MBDurbin/VRB/PROJECT_CONTEXT.md

# Resistor Bank Master — Project Context

Self-contained summary of the system, its validated constants, and its open
questions. Written to be dropped into a Claude Project (or read cold by anyone
new to the repo).

Last updated: 2026-10-08. Reflects the move to Reliance RS50 cells and the
October 2026 safety-review fixes.

---

## What this system does

An FSAE electrical-load test rig. It discharges **one 12S4P module** through a
relay-switched resistor bank, following a recorded lap speed profile, so that
module can be characterized under realistic race loads without a car. The car
itself carries nine such modules in series; the rig reproduces what one of them
would experience. See Battery topology below — this distinction matters.

The lap profile drives a road-load physics model (drag, downforce, rolling
resistance, translational and rotational inertia, drivetrain loss) to compute
required power for each row. That power is converted to a target resistance,
quantized to the bank's 0.25 Ω steps, and sent to the resistor Arduino as an
8-bit binary word.

**Playback follows the profile's own `Time (s)` column**, via
`lap_row_interval()`. It used to advance one row per wall-clock second
regardless, which happens to match the shipped 1 Hz profile but would run a
10 Hz log ten times too slow *and* hold each power demand ten times too long,
over-draining the pack by the same factor. `compute_lap_physics()` already
derived acceleration from those timestamps, so fixed playback also made the two
disagree about how much time a row represents.

**Lap boundaries are continuations, not restarts.** `is_first_row` means the
standing start of the *run* (lap 1, row 0) — tying it to `row_idx == 0` alone
made every subsequent lap begin from rest, discarding the car's carried velocity
and dropping the acceleration term from that frame's power demand. And because
the profile's `Time (s)` restarts each lap, the raw difference at the boundary
is large and negative (`0.0 - 60.0`); the non-positive guard silently replaced
it with 1.0 s, dividing a real velocity change by a fabricated interval. That
frame now uses `lap_row_interval()` — the profile's own sampling rate, not a
literal, so it stays correct at any log rate.

Note the shipped profile begins and ends at 0 mph, so its own boundary is
benign. A multi-lap run on it is N repeats of a stop-to-stop lap rather than a
continuous stint. The fix matters for profiles that are loop-closed at speed.

`load_lap_profile()` drops rows with non-finite speed or time. Exported
telemetry commonly carries trailing blanks — the shipped profile has seven — and
NaN propagates to a NaN power demand, which loses every comparison in
`compute_target_resistance()` so `min(MAX_RESISTANCE, nan)` quietly returns
`MAX_RESISTANCE`. The bank sat at minimum load for the tail of every lap with
nothing reported.

## Architecture

Four processes communicating over bounded `multiprocessing.Queue`s. `main_v2.py`
orchestrates and picks the data source at startup.

```
                 daq_queue              telemetry_queue
hardware_manager ──────────> control_logic ──────────> gui_layout
  (or sil_simulator)              ^                        │
                                  └────────────────────────┘
                                       gui_cmd_queue
```

| Module | Role |
|---|---|
| `main_v2.py` | Entry point. Probes COM ports for a `SIL_KEY` dongle; if present runs SIL mode, otherwise starts the real DAQ process. |
| `rig_config.py` | Vehicle model, pack spec, DAQ mapping and safety limits, with JSON persistence. Everything a future team retargets lives here. |
| `theme.py` | Colour, type and spacing for the whole interface. One global stylesheet; widgets carry a `variant` property rather than inline CSS. |
| `hardware_manager.py` | Reads NI cDAQ (current + cumulative cell voltage taps, plus resistor-bank thermocouples on banks 1–4 in their own task and thread) and the temperature Arduino (OneWire buses of DS18B20s). Channel map and sensor layout come from config. Self-healing watchdog thread re-detects the temperature Arduino. Without the NI-DAQ it publishes zero current and voltage flagged `ni_daq` False, never simulated data. |
| `control_logic.py` | The safety-critical process. FSM, safety trips, lap physics, coulomb counting, resistor bank serial commands. |
| `gui_layout.py` | PyQt6 telemetry UI — live voltage/current plots, 12S cell voltages, 48-sensor thermal heatmap, resistor bank map laid out as built, threshold controls, CSV recording. |
| `sil_simulator.py` | Desk-test plant model. Replaces the DAQ entirely with operator-driven sliders (load, temperature, pack OCV) plus a hardware-fault toggle. |

These run the rig and stay at the top level. Lap profiles, bench tools, the
cooling analysis and the superseded prototypes each have their own folder; the
map is in [README.md](README.md).

### Finite state machine

```
DISCONNECTED ──> IDLE ──ARM──> ARMED ──RUN──> RUNNING
                  ^                              │
                  └──────────(laps complete)─────┘

any state ──STOP/trip──> FAULT ──RESET──> IDLE
```

Guards live in `is_valid_transition()`. `ARM` only from `IDLE`, `RUN` only from
`ARMED`, `RESET` only from `FAULT`, `STOP` always accepted. `ARM` is also refused,
staying in `IDLE`, while `arm_refusals()` is non-empty: the NI-DAQ is offline or
the configuration has ARM blockers (see Retargeting below).

`ARM`, `RUN` and `RESET` carry the time they were pressed
(`transition_command()`), and the loop ignores one pressed before the most
recent stop or fault (`stale_transition()`). Without that, a `RESET`, `ARM` and
`RUN` already waiting in the queue were processed straight after an E-STOP, in
the same pass, and the rig was `RUNNING` again with the next resistance command
reconnecting the load. A fault is cleared only by a `RESET` pressed after it.

## Hardware

- **Module under test**: 12S4P Reliance RS50 (21700, 5000 mAh, 70 A), 48 cells,
  ~50 V, 280 A. This is what the bench actually loads. It replaced the Molicel
  INR-21700-P45B the modules were first built with; see Cell constants below.
- **Car's battery** (reference only): 9 modules in series, 432 cells, ~450 V.
- **Resistor bank**: binary ladder of 8 relay-switched steps —
  0.25, 0.5, 1, 2, 4, 8, 16, 32 Ω. 0.25 Ω resolution, 63.75 Ω total, 255 steps
  in an 8-bit word. Wired across the module under test.
- **Resistor Arduino**: 9600 baud, answers `RESISTOR_CTRL` to `?WHOAMI`. Has an
  independent 2 s serial watchdog that opens the main contactor and sheds all
  load if the host goes quiet.
- **Temperature Arduino**: 115200 baud, answers `TEMP_SENSOR`. 6 buses × 8
  sensors, 9-bit resolution for speed, non-blocking state machine.
- **NI cDAQ**: modules 5–8, 10:1 dividers (`VOLTAGE_MULTIPLIER = 11.0`).

Both Arduinos and the SIL dongle are discovered by COM-port sweep using the
`?WHOAMI` handshake — no fixed port assignments.

**One process owns each device, and only that process sweeps for it.**
`control_logic` owns the resistor controller; `hardware_manager` owns the
temperature Arduino. Both used to hunt for `RESISTOR_CTRL`, which meant
`hardware_manager` could never claim the port `control_logic` was holding, so
its "still looking" flag never cleared and the sweep ran every 3 s forever —
blocking 2 s per baud per port, and DTR-resetting any Arduino it managed to
open. If a sweep landed inside `control_logic`'s reconnect cooldown it could
grab the resistor controller and reset it out from under the process driving the
bank. Keep discovery single-owner.

**[docs/hardware_topology.md](docs/hardware_topology.md) is the physical
reference**: what each ladder step is actually built from, how the bank is
arranged for cooling, the DS18B20 ROM address map, and the gaps between what the
hardware needs and what the software enforces. Two of those gaps matter before
any run — **there is no fan interlock**, and the bank has **no thermal
protection of its own**.

## Interface conventions

All styling lives in `theme.py` and is applied as one global stylesheet via
`apply_theme(app)`. Widgets declare intent with a `variant` property
(`primary`, `success`, `warning`, `danger`, `card`, `section`, `caption`,
`mono`) instead of carrying their own CSS, so the look stays coherent as the
interface grows. Three conventions are worth preserving:

- **Colour carries meaning.** Red is a fault or a hard limit, amber is a warning
  or an armed-but-not-running state, green is healthy or active. Nothing
  decorative uses those three, so an operator can trust what a colour means.
- **Live numbers are monospaced.** Proportional digits change width as values
  update, which makes readouts visibly twitch. Metric cards also hold a fixed
  width and static captions for the same reason — a caption that grows with its
  value makes the card reflow mid-run.
- **The E-STOP is deliberately the loudest control on screen** and sits apart
  from the routine controls, so it cannot be hit while reaching for Run or
  Reset. Do not tone it down for visual balance.

The thermal map ramp (`theme.HEAT_STOPS`) routes cool → teal → amber → red
rather than interpolating blue straight to red, which passes through a muddy
purple midpoint and makes mid-range cells impossible to rank.

## Retargeting the rig for a new car or new cells

**Start here if you have inherited this rig.** Click **⚙ CONFIGURE** in the GUI.
Nothing below requires editing Python.

The dialog has two tabs. **Vehicle** describes the car — mass, aero, tyres,
drivetrain. **Battery Pack** takes the numbers straight off your cell's
datasheet plus your series/parallel counts. Pack limits are *derived* from those
values, so entering `70 A` continuous and `4P` produces a 280 A pack rating
automatically; you should never be hand-computing a pack limit.

A live panel shows the derived pack figures and the resulting trip points as you
type, and warns in red if a limit would exceed what the cells are rated for.
Settings persist to `rig_config.json` beside the source, so they survive
restarts and travel with the repo.

One safety rule is enforced in the derivation: **the E-STOP fires at
`max_amps + amp_buffer`, so the buffer is taken out of the cell rating, not
added on top of it.** With the RS50's 280 A pack and a 5 A buffer the operating
limit derives to 275 A and the trip lands exactly on 280 A. Deriving the limit
as the raw rating would put the real trip at 285 A — above the cells — which is
exactly the bug that shipped originally, on the P45B's 180 A pack, as
182 A / 187 A.

Hand-editing a threshold in the sidebar that derivation computes (V crit, cell
min, max current, max temp, derate start) sets `derive_from_pack = False`, so
your override is not reverted the next time the config loads. Re-enable
derivation by editing that flag in `rig_config.json`. The other sidebar controls
are not overrides and leave derivation on: **V warn** only moves a dashed line on
the plot and never reaches the controller (it used to switch derivation off for
every limit), and changing the **E-stop buffer** or the **thermal derate**
switch re-derives, so max current follows a new buffer and the trip stays on the
cells' rating.

**What the window shows is checked against what the controller is using.** The
logic process reports its limits in force and a fingerprint of its vehicle, pack
and wiring (`settings_fingerprint()`) in every telemetry packet. If they differ
from the window's for more than a second, a red `NOT IN FORCE ON THE
CONTROLLER` line appears beside the car and pack label, naming the setting. That
catches a config the controller rejected and a `SET_LIMITS` or `SET_CONFIG` the
bounded command queue dropped. Configure is refused outright while RUNNING,
because the controller ignores a new config mid-run; it used to apply and save
it in the window anyway, so a lowered max temp could look active when it was
not. The Configure preview also works on a copy of the limits now: it used to
re-derive into the live limits on every keystroke, so Cancel undid nothing.

**Editing `rig_config.json` by hand is different.** If you change a limit there
and leave `derive_from_pack: true`, derivation still wins — that is deliberate,
because a pack change must move the limits with it, or new cells inherit the old
pack's ceiling. What is *not* acceptable is doing it quietly: the reversion can
run in the unsafe direction, turning a deliberate derate from 120 A back into
175 A. So every discarded value is now reported on the console at startup and in
a dialog when the GUI opens. If you meant the edit, set `derive_from_pack` to
`false`.

The **DAQ / Sensors** tab holds the channel mapping and sensor layout: which
cDAQ channel reads current, the ordered list of cumulative voltage taps, divider
and transducer scaling, analog input range, OneWire bus/sensor counts, and the
loop period. These describe physical wiring, so they cannot be *derived* from
S/P counts — but they must agree with them, and the dialog says so in red when
they do not (e.g. "12 voltage channels configured but the pack is 14S").

**Configuration problems come in two classes, and one of them blocks ARM.**
`RigConfig.arm_blockers()` lists the ones that leave part of the module or bank
unwatched: a voltage-tap count that does not match the series count, the
current channel or a thermocouple on a voltage input, duplicate channels, an
invalid thermocouple type or cold-junction source, a non-positive divider or
transducer scale (zero reads no current; negative reads discharge as negative,
which never reaches the over-current trip), a staleness timeout at zero (which
switches that monitor off), any limit that is not a finite number (a trip set to
NaN never fires), and any trip set past a rating, so that it fires only after the
damage: over-current above the pack rating, max temp above the cell's ceiling,
undervoltage below the cutoff, or a resistor trip above its element's rating.
These used to be printed as warnings and the rig armed anyway. They are judged
on the limits the logic process actually holds, so a **sidebar edit** counts the
same as the config file. The logic refuses `ARM` while any stand, the main
window says why in red beside the hardware pills, and a config or sidebar change
that introduces one while armed faults as `CONFIG FAULT` and kills the load.
Everything else is an advisory (`RigConfig.advisories()`), shown and left to the
operator: a derate that cannot ramp (it fails safe to no load), a thermistor
count that does not match the cell count, no resistor thermocouples or a bank
with a trip and no thermocouple, and a bad sample period. Fewer thermistors than cells and missing
thermocouples are advisories by choice, so a rig still being instrumented can
arm; an armed rig whose thermocouples deliver nothing still faults as
`NO RESISTOR TEMP DATA`. A config with blockers can still be saved, so a team
mid-rewire can save and restart.

**The resistor bank is held to its power ratings per bank**, not just to its
8 kW total, and a sidebar switch chooses between 100% and 140% of them. See
"The bank's power ratings" in [docs/hardware_topology.md](docs/hardware_topology.md).

DAQ changes only take effect on restart, because the NI task and sensor buffers
are built once at process start. The GUI tells you this after saving rather than
letting you believe a rewiring change is already live. ARM is judged against the
wiring the DAQ is actually running, so correcting a channel list in the dialog
does not unblock it until after the restart.

### What retargeting does NOT cover

- **Arduino firmware.** The temperature sketch hardcodes 48 DS18B20 ROM
  addresses across 6 buses. A different sensor count means editing and
  re-flashing the sketch — the Python side will read whatever layout you
  configure, but the addresses themselves live in firmware.
- **Resistor bank hardware.** 8 relays, 0.25 Ω resolution, 63.75 Ω max are
  physical properties of the bank.
- **Physically rewiring the DAQ.** Configuring 14 channels does not create them;
  you need the modules and the taps.

Everything on the Python side now follows the config: the DAQ derives cell
voltages by differencing however many taps are configured, sizes its temperature
grid from the bus/sensor counts, and the GUI adapts its cell list, thermal map
and CSV columns to match.

## Vehicle model

All road-load parameters live in the `VehicleParams` dataclass in
`rig_config.py` (re-exported from `control_logic` for convenience) — nothing
physics-related is hardcoded in the maths any more. Edit these from the GUI's
Configure dialog, or pass a variant per call:

```python
fast = VehicleParams(drag_coefficient=0.55, rotational_mass_factor=1.08)
compute_required_power(velocity_ms, acceleration, params=fast)
```

| Field | Default | Notes |
|---|---|---|
| `mass_car_kg` / `mass_driver_kg` | 260 / 70 | 330 kg total |
| `rotational_mass_factor` | 1.05 | Wheels, rotors, axles, drivetrain as virtual mass |
| `air_density_kgm3` | 1.2255 | ISA sea level, 15 °C |
| `gravity_ms2` | 9.81 | |
| `drag_coefficient` / `drag_area_m2` | 0.6 / 2.224 | |
| `lift_coefficient` / `downforce_area_m2` | −1.0 / 2.224 | Negative Cl = downforce |
| `rolling_resistance_coeff` | 0.015 | Applied to the *dynamic* normal force |
| `drivetrain_efficiency` | 0.95 | Chain/gears/bearings |

Two modelling subtleties that are easy to get wrong and are locked by tests:

- **`rotational_mass_factor` applies to acceleration only.** Spinning components
  resist changes in speed but do not press the tyres into the track, so the
  factor must not reach the normal force behind rolling resistance. It has zero
  effect at steady speed.
- **Drivetrain efficiency is asymmetric.** Driving divides by η (the powertrain
  must produce more than reaches the road); braking multiplies by η (friction
  eats part of what would return). η is clamped to [0.01, 1.0] at the use site
  so a mistyped value cannot divide by zero inside the safety-critical process.

`compute_road_load_forces()` returns the individual force terms (drag,
downforce, rolling, accel, total) so the breakdown can be inspected and tested;
`compute_required_power()` builds on it and applies the efficiency correction.

Effect of the rotational-mass and efficiency terms versus the earlier model:
**+5.26 %** at steady speed (efficiency alone), rising to **+10.3 %** under hard
acceleration. At 10 m/s and a = +8 m/s² that moves the bank from 6.73 Ω to
6.10 Ω — roughly two 0.25 Ω steps, so it is resolvable by the hardware rather
than lost in quantisation.

## Cell constants — Reliance RS50

The module has been **Reliance RS50** since it replaced the Molicel
INR-21700-P45B. The figures come from the supplier's listing (liionwholesale.com,
"Reliance RS50 70A 5000mAh Flat Top 21700"); there is no RS50 datasheet in the
repo yet. Two figures the rig needs are **not on that listing** and are flagged
below. The P45B's datasheet stays in `datasheets/` for reference: some tests pin
the derivation math to its published figures.

| Quantity | Cell | 12S4P module | Source |
|---|---|---|---|
| Capacity | 5000 mAh typical, 4950 mAh min (0.2 C) | 20.0 Ah (19.8 Ah min) | listing |
| Full charge | 4.2 V | 50.4 V | listing ("peak voltage") |
| Nominal | 3.6 V | 43.2 V | listing |
| Max continuous discharge | 70 A "with 80 °C temperature cut-off" | **280 A** | listing |
| Discharge temperature limit | 80 °C | 80 °C over-temp trip | listing (its only temperature figure) |
| Discharge cutoff | 2.5 V | 30.0 V absolute floor | **not on the listing** — usual for the class; confirm |
| DC internal resistance | 4 mΩ | 12 mΩ | **not on the listing** — an estimate; confirm or measure |
| Energy | 18 Wh | 864 Wh | 5.0 Ah × 3.6 V |
| Charge current | 15 A max, 8 A standard | — | listing; the rig never charges |

Pack derivation (`derive_from_pack: true`) turns these into the trips: 275 A
operating current and a 280 A over-current trip, 80 °C max temp, 36.0 V module
undervoltage (3.0 V/cell), 2.70 V per cell, and a 38.0 V warning line.

**80 °C is the right trip for this cell.** The P45B needed care here: its 45 A
rating carried an 80 °C *test* cut-off while its discharge operating range
stopped at 60 °C, so the rig used 60. The RS50 listing gives only the 80 °C
cut-off with its 70 A rating and no separate operating range, so the rig trips at
80. Lower `cell_max_temp_c` if an RS50 datasheet gives a narrower discharge range.

**Why the undervoltage trip sits at 36.0 V and not 30.0 V:** headroom for sag.
The RS50 module's 12 mΩ sags 3.4 V at its 280 A rating, about 2.4 V at the
~200 A the ladder can actually draw. The 3.0 V/cell figure came from the P45B,
whose 45 mΩ sagged 8.1 V at 180 A; it still leaves the RS50 well clear of its
cutoff.

`rig_config.json` used to say `max_amps: 180`, the P45B's figure. With
`derive_from_pack: true` it was replaced by the RS50's 275 A on every load, behind
a "hand-edited limits were replaced" dialog, so 275 A was already in force. The
file now says 275.

### What bounds the load: battery current and bank power

Two independent limits, each enforced on what is commanded and again as a trip:

| Limit | On the command | As a trip | Can configuration raise it? |
|---|---|---|---|
| **Battery current** — 280 A for the RS50 module (70 A × 4P) | Resistance never below V ÷ 275 A, rounded up a step | Over-current at 275 + 5 = 280 A, in any state | No: a trip above the pack rating blocks ARM |
| **Bank power** — 8 kW ladder total and each bank's own rating (`BANK_RATED_POWER_W`) | Every setting checked against both at worst-case tolerance; one that fails moves to the nearest that passes | Ladder V × I in any state; each bank's share once a setting has settled | Only between 100% and 140% (the sidebar switch) |

**With the RS50 the bank binds first.** The 0.25 Ω bottom step limits a full
50.4 V module to about 202 A, under the cells' 280 A, so the over-current trip is
a backstop for a fault such as a shorted ladder rather than a limit the rig
reaches in use. At full charge the heaviest load is 0.25 Ω and ~10.2 kW with the
default 140% bank setting; held to rated power, it is 0.75 Ω and ~3.4 kW above
43.6 V. `tests/test_shipped_limits.py` runs every setting the shipped config can
command, across the charge range and at both bank settings, against both limits.

## Battery topology — read this before touching the physics

**The bench loads ONE module. The car has nine of them in series.** Almost every
mistake in this codebase has come from conflating the two.

- A module is `series_count` × `parallel_count` cells (default 12S4P, ~50 V).
- The car's battery is `modules_in_series` (default 9) of those in series, ~450 V.
- The DAQ reads taps on **one** module, and the resistor bank is wired across
  **that one module only**. So `voltage` in the telemetry packet is ~50 V, and
  the bank never sees 450 V.
- Series modules all carry the same current, so **the RS50 module's 280 A is
  simultaneously the per-module limit and the whole-battery limit**. Current limits do not scale
  with module count.

The lap physics computes power for the **whole car**, drawn from the 450 V
battery. Reproducing that on one module means reproducing its **current**:

```
I_car = P_car / V_battery = P_car / (N · V_module)
R     = V_module / I_car  = N · V_module² / P_car
```

So the module count enters the power term **linearly**, and both current clamps
divide the **module** voltage, because that is what is actually across the bank.

This was the source of a real bug. The term read `(voltage * 9) ** 2` — N²
rather than N, which is the resistance for a bank spanning the entire battery.
On a single-module bench that **under-loaded by a factor of 9** across the whole
lap: an 81 kW demand drew 20 A instead of 180 A, and no plausible car power could
reach the ladder's 0.25 Ω step (it would have needed 810 kW). With the fix, 81 kW
lands at 180 A and 0.278 Ω — just above the smallest step, which is what the
hardware was sized for.

Sanity check any change here against the ladder: 0.25 Ω ↔ 200 A ↔ ~90 kW.

## Safety layers

Three independent layers. They must all be verified separately.

1. **Software trips** (`evaluate_safety` in `control_logic.py`) — over-temp,
   over-current, module undervoltage, **per-cell undervoltage**, cell sense
   fault, and **temperature data staleness**. Measured dangers are reported
   ahead of data-integrity faults, so an over-current with a dead thermal link
   reports the current. Sends `KILL` to the resistor Arduino and latches
   `FAULT`, which only a manual `RESET` clears.

   Two of these exist because pack-level checks alone were not enough:

   - **Per-cell undervoltage.** Eleven cells at 3.40 V plus one at 1.00 V totals
     38.4 V — above a 36.0 V module trip — while that one cell is destroyed. A
     module-total trip cannot see it. Readings below `cell_sense_floor` report
     as a sense fault rather than undervoltage, because a flat cell and an
     unplugged sense lead are indistinguishable and both must stop the run.
   - **Temperature staleness.** The DAQ republishes its last temperature array
     when the sensor link drops, so a dead sensor looks like a steady pack. A
     link lost at 52 °C froze the reading at 52 °C and the overtemp trip could
     never fire while the cells kept heating. Readings now carry an age and are
     refused past `temp_stale_timeout_s`.

   **Over-temperature and over-current are checked in every state.** Everything
   else — undervoltage, per-cell, and all data-integrity checks — applies only in
   `ARMED`/`RUNNING`, because before arming those readings describe a bench that
   is not loaded yet. A rig powered up before the battery is plugged in reads
   0.0 V; tripping on that in `IDLE` latched a fault `RESET` could not clear
   (back to `IDLE`, instantly re-trips) and locked the operator out of software
   bring-up entirely.

   Once armed, missing data is a **fault**, not a reason to skip a check.
   `check_cell_safety` reports `NO CELL DATA` on an empty array rather than
   returning safe — a broken harness or empty channel list would otherwise run a
   high-power profile blind to exactly what that check exists for.

   **Readings are checked before any trip trusts them** (`measurement_problems()`,
   once armed). NaN loses every comparison, so a packet of NaN current, voltage
   and cells used to pass every trip; and a packet with one cell, one sensor and
   one thermocouple passed too, because nothing counted them. Now:
   `INVALID READING` for anything not a finite number, a current below −20 A
   (a reversed or saturated transducer hides over-current), a module above 110%
   of full or a cell more than 0.8 V above full (either can never trip
   undervoltage), or a cell temperature below the DS18B20's −55 °C; and
   `INCOMPLETE DATA` when the counts of cells, temperature sensors or
   thermocouples differ from the wiring. Empty arrays keep their own names
   (`NO CELL DATA` and its siblings). The temperature parser also drops any
   value outside −55…125 °C, so the library's −127 "disconnected" value can
   never count as a fresh reading (the sketch already sends `ERR` for it). A
   NaN current sample is skipped by the coulomb count rather than freezing the
   SOC at 100%.

   **No simulated pack without the NI-DAQ.** `hardware_manager` used to
   substitute a healthy pack at rest (15 A, every cell at nominal + 0.5 V) when
   the DAQ failed to start, so a rig started without its DAQ drove the real bank
   while the overcurrent, undervoltage and cell trips watched made-up numbers.
   It now publishes zero readings with `hardware_status['ni_daq']` False. `ARM`
   is refused on them (the state stays `IDLE`, nothing to reset), and a DAQ lost
   after arming faults as `NI-DAQ OFFLINE` on the next packet and kills the load
   rather than waiting out `DAQ DATA STALE`. A failed read no longer ends the DAQ
   process, so temperatures keep reaching the GUI; it does not retry, so restart
   once the DAQ is back. Desk testing on simulated data is what the SIL dongle
   is for.

   **The logic loop never skips its body.** It previously did `continue` when the
   DAQ queue was empty, which jumped past GUI commands, every safety check, the
   resistor heartbeat and telemetry forwarding. A hung DAQ therefore paralysed
   the logic process: the operator's E-STOP sat unread in the queue and the GUI
   kept displaying `RUNNING`. The Arduino's own 2 s watchdog still shed the load,
   but nothing in software noticed or reported it. The loop now carries the last
   packet forward tagged with its age, and `DAQ DATA STALE` faults on it.

   **A failed write to the resistor controller is a lost link.** Every write
   goes through `write_resistor()`, which returns False rather than raising. A
   failed heartbeat, command or KILL, or a port that closes under the loop,
   closes the handle, re-arms discovery and, if ARMED or RUNNING, latches FAULT
   (`RESISTOR LINK LOST`). Heartbeat and command failures used to be swallowed,
   leaving the GUI showing a connected controller and RUNNING; the KILL writes
   were unguarded and could crash the process. Writes time out after 0.25 s
   rather than blocking. The loop sits in `try/finally`, so however it ends the
   load is killed and the port closed, and an unexpected error sends the GUI a
   final FAULT packet. **Limit:** the firmware does not answer `alive`, so a
   controller that hangs while still enumerated is not detected by the host;
   its own 2 s watchdog is what sheds the load then.
2. **Operator E-STOP** — GUI button, raises its own latched `estop_event`
   (`request_estop()`) rather than queueing a `STOP`, and the logic loop takes it
   ahead of every queued command. It used to go through
   `send_command_nonblocking()`, which makes room in a full queue by taking an
   old command out; a `multiprocessing.Queue` can refuse that for a moment after
   its own puts, so a STOP pressed into a full queue could be dropped while
   heartbeats carried on and the Arduino watchdog never fired. An Event has no
   capacity to run out of. Any `ARM`, `RUN` or `RESET` pressed before the stop
   is void (see the state machine above).
3. **Arduino serial watchdog** — 2 s of host silence opens the main contactor
   and sheds all load, independent of the host entirely.

Layer 3 is the backstop when layer 1 is stalled (see Open Questions).

## Testing

```bash
python -m pytest
```

194 unit tests, no hardware required. They cover the pure decision logic extracted
from the control loop: trip thresholds at/around boundaries, FSM transition
guards, coulomb counting and SOC clamping, the thermal derate curve, road-load
power, and the E-STOP command dispatch path.

`tests/SIL_CHECKLIST.md` is the manual desk-test procedure for what unit tests
structurally cannot reach — process/queue plumbing, GUI responsiveness, timing,
and shutdown hygiene. Requires the SIL dongle; no battery or DAQ needed.

## Bugs found and fixed (2026-07-23 → 25)

| Bug | Consequence |
|---|---|
| DAQ process never started in physical mode | `daq_queue` stayed empty, control loop never ran without the SIL dongle — bank and safety monitors effectively dead |
| Arduino watchdog never reset `MainRelay` after the first timeout | One serial hiccup stranded the main contactor open until power cycle |
| `auto_detect_resistor()` probed at 115200 vs the Arduino's 9600 | `?WHOAMI` handshake could never succeed |
| Reconnect scans ran every DAQ tick, no cooldown | Telemetry loop stalled seconds at a time (~2–4 s per COM port) |
| Spinboxes used Qt default `keyboardTracking` | Typing `100` into Max Temp emitted 1 → 10 → 100; the intermediate `1.0` applied as a live limit and tripped a spurious OVERTEMP kill mid-run |
| GUI buttons used blocking `.put()` on a bounded queue | A full queue froze the UI including E-STOP |
| Derate divided by `(max_safe_temp - derate_start_temp)` unguarded | `ZeroDivisionError` crashed the safety-critical process on misconfigured thresholds |
| **No undervoltage protection existed** | `V Warn`/`V Crit` only moved dashed lines on the plot; they were never sent to the logic process. Nothing prevented discharge past the 2.5 V/cell cutoff |
| Current limit 182 A, temp limit 65 °C (P45B pack) | Both exceeded datasheet ratings (180 A / 60 °C). E-STOP only fired at 187 A = 46.75 A/cell, 3.89 % over rated |

## Open questions and known gaps

**0. Coulomb count carries across runs, and only rebaselines on restart.**
`RUN` used to reset `remaining_ah` to full, so two manually-triggered
back-to-back laps both started at 100% and the counter forgot what the first
drew — overstating remaining charge, the dangerous direction. It now carries
over, and the starting SOC is printed when a run begins. It rebaselines on a
pack/config change or a process restart. If you want an explicit "fresh battery"
reset in the GUI, that is a deliberate affordance someone should add; silently
doing it on every `RUN` was not.

**1. SOC reads optimistically high.** `coulomb_step` integrates against a fixed
20.0 Ah nameplate figure. Two problems: it uses *typical* capacity (5000 mAh)
rather than *minimum* (4950 mAh, → 19.8 Ah), overstating by up to 1 %; and it
ignores rate dependence, though the ~200 A the ladder can draw is a 10 C
discharge where real deliverable capacity is meaningfully lower. Quantifying the
second needs a discharge-rate curve, and the RS50 listing has none.

**2. The regen branch of the power model is currently inert.**
`compute_target_resistance()` maps any `req_power <= 0` to `MAX_RESISTANCE`, so
braking power of −51.7 kW and −52.2 kW command the same 63.75 Ω — the bank is
purely dissipative and cannot recover energy. The braking efficiency correction
is still physically correct and matters if computed power is ever used for
energy prediction, but it does not change bank behaviour today. Coulomb counting
uses measured current, not this figure, so it does not propagate there either.

**3. E-STOP latency during port scanning.** The queue fix guarantees the GUI
never freezes, but the logic process still cannot *act* on a STOP while blocked
inside `auto_detect_resistor()`. This is tolerable only because `res_ser` is
`None` during a scan — the resistor Arduino is disconnected, so its own 2 s
watchdog has already shed load in hardware. **This means load-shedding in that
window rests entirely on the Arduino watchdog, not on software.** Verify on the
bench.

**4. The `SIL_KEY` dongle firmware is not in this repo.** `main_v2.py` probes for
a device replying `SIL_KEY` to unlock software-in-the-loop mode, and no such
sketch exists on the development machine. The other three sketches now live in
`arduino/` — see that folder's README. If the dongle exists, its firmware is
elsewhere and should join them.

**5. No cross-validation between threshold spinboxes.** Nothing prevents setting
`V Warn` below `V Crit`, or `Derate Start` above `Max Temp`. The derate case now
fails safe rather than crashing, but the UI still accepts nonsense combinations.

**6. Everything so far is desk-tested only.** No validation against real
hardware, real cells, or real current has been performed.
