MBDurbin/VRB/analysis/plots/CFM_vs_Resistor_Count.png

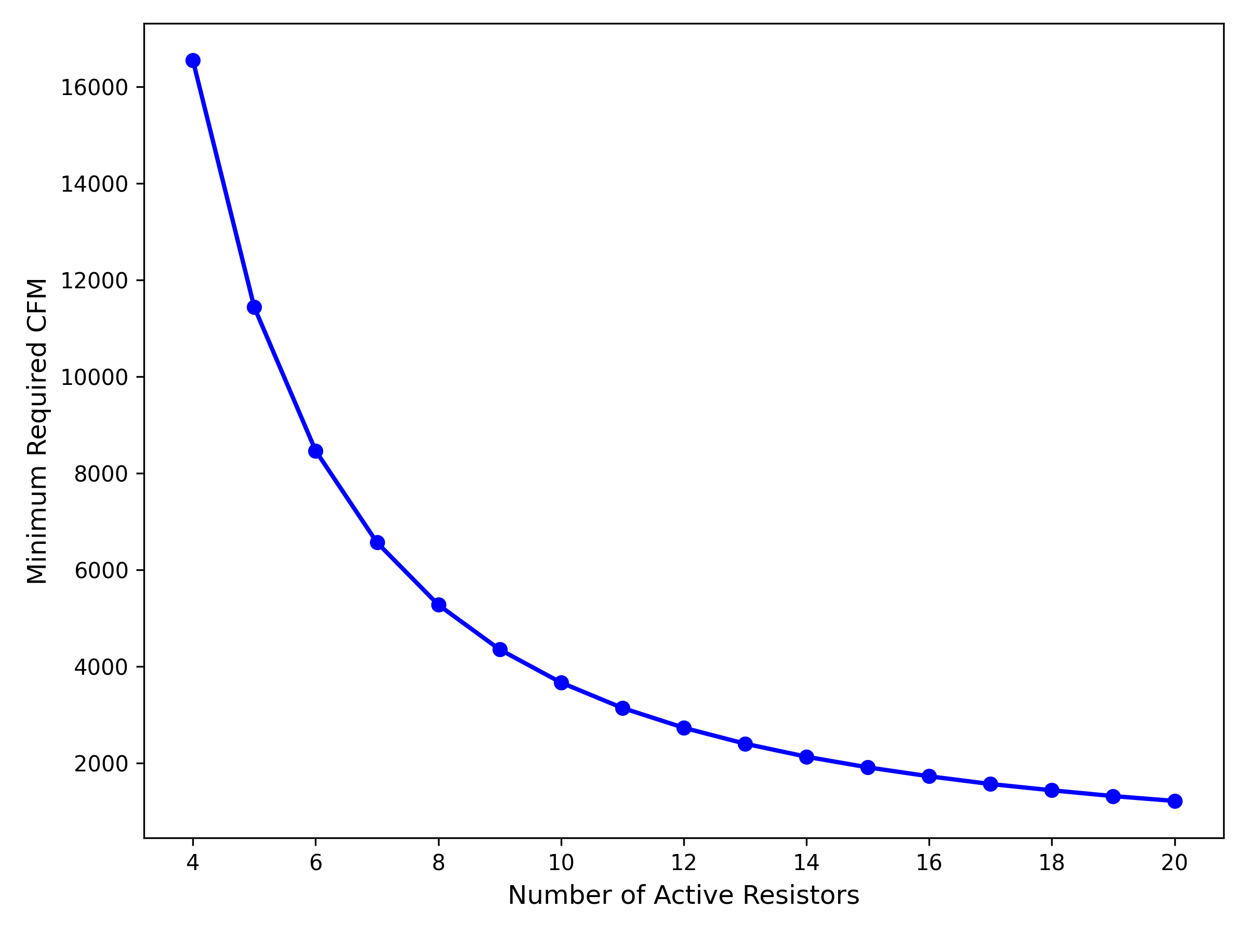
analysis/plots/CFM_vs_Resistor_Count.png
