MBDurbin/VRB/analysis/plots/CFM_vs_Surface_Temp.png

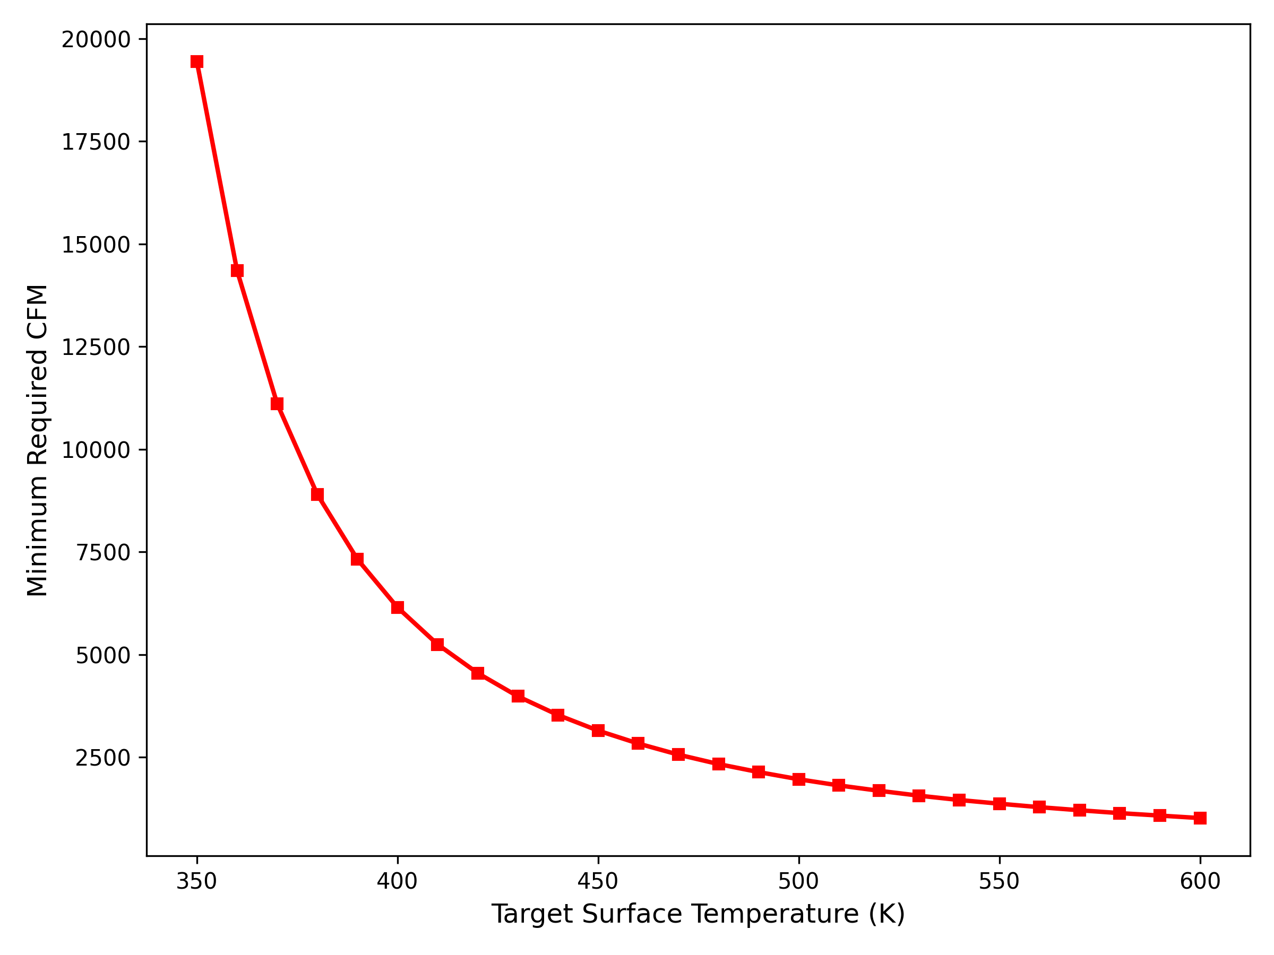
analysis/plots/CFM_vs_Surface_Temp.png
