MBDurbin/VRB/analysis/plots/Sensitivity_1_Clean_LogScale.png

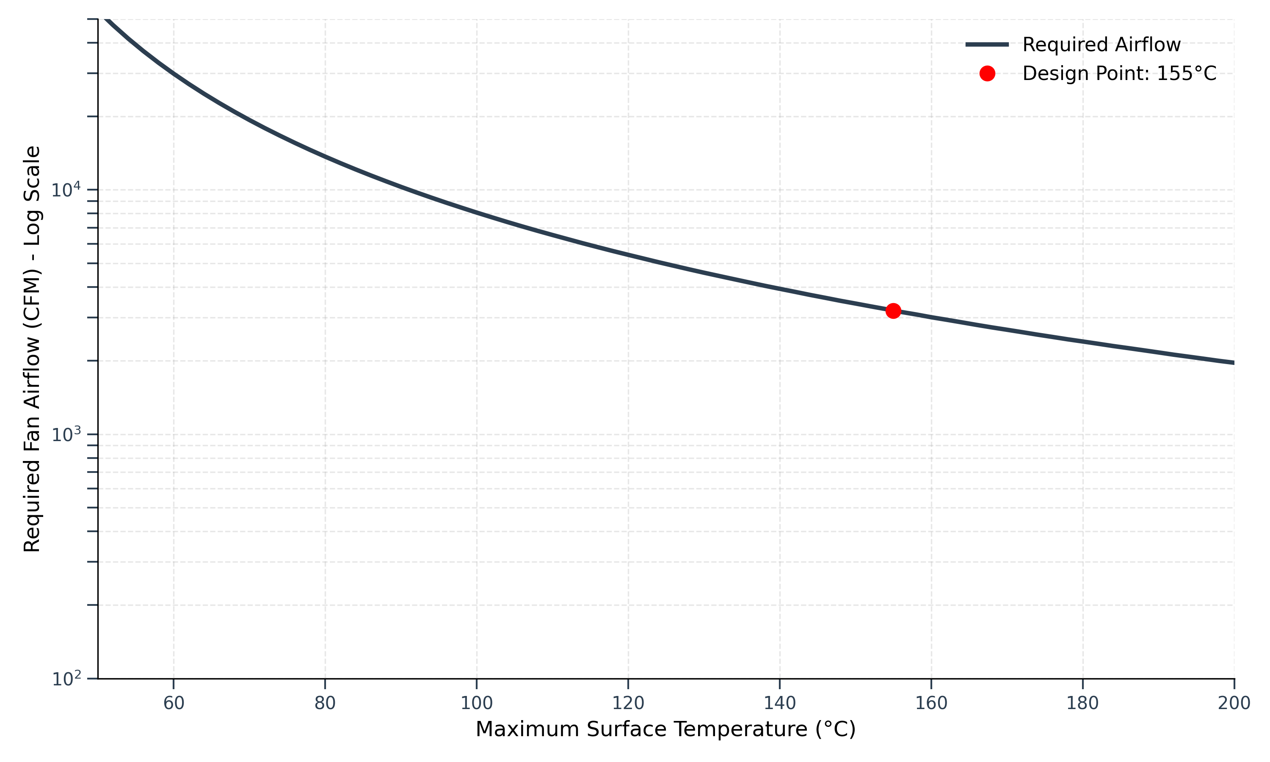
analysis/plots/Sensitivity_1_Clean_LogScale.png
