MBDurbin/VRB/analysis/plots/Sensitivity_1_Surface_Temp.png

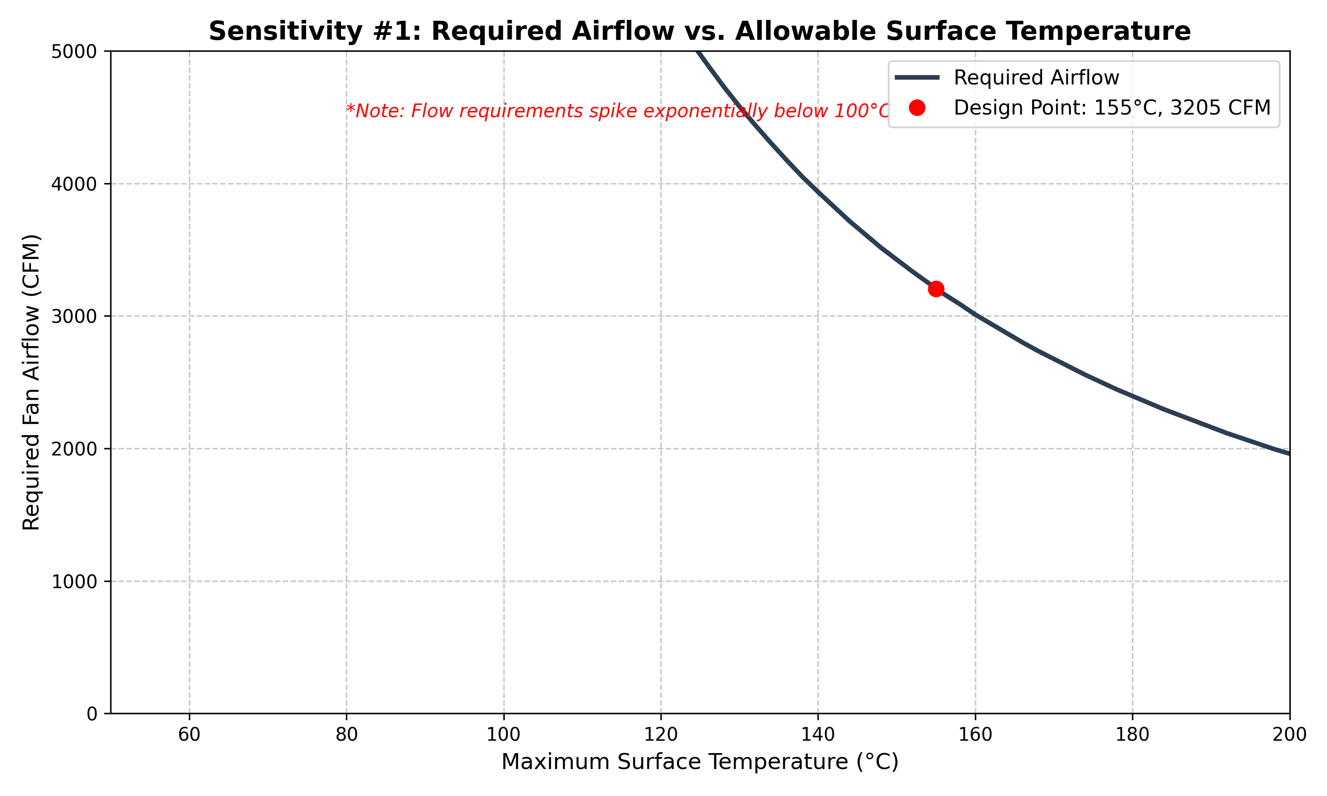
analysis/plots/Sensitivity_1_Surface_Temp.png
