MBDurbin/VRB/analysis/plots/Sensitivity_1_Surface_Temp_LogScale.png

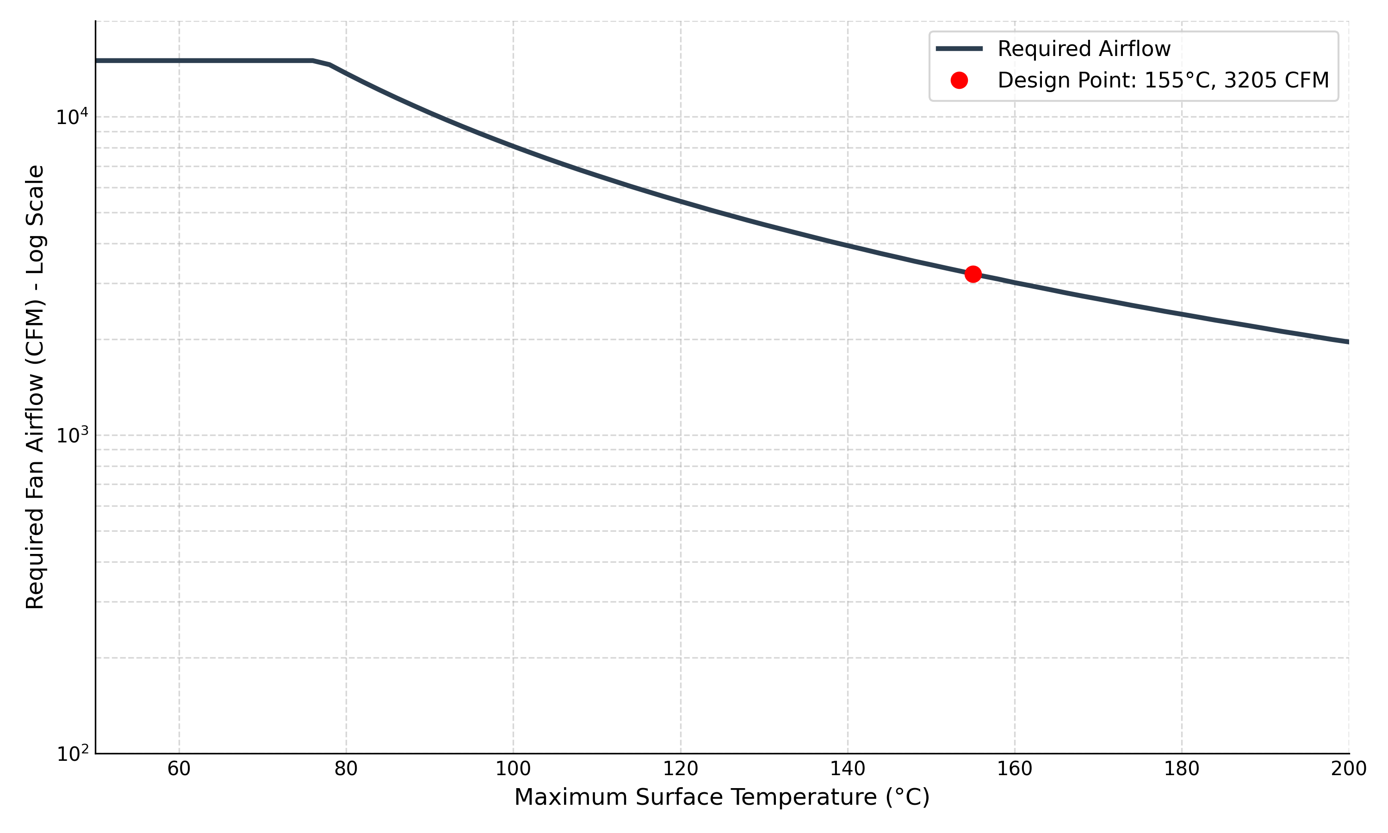
analysis/plots/Sensitivity_1_Surface_Temp_LogScale.png
