MBDurbin/VRB/analysis/plots/Sensitivity_2_Resistor_Count.png

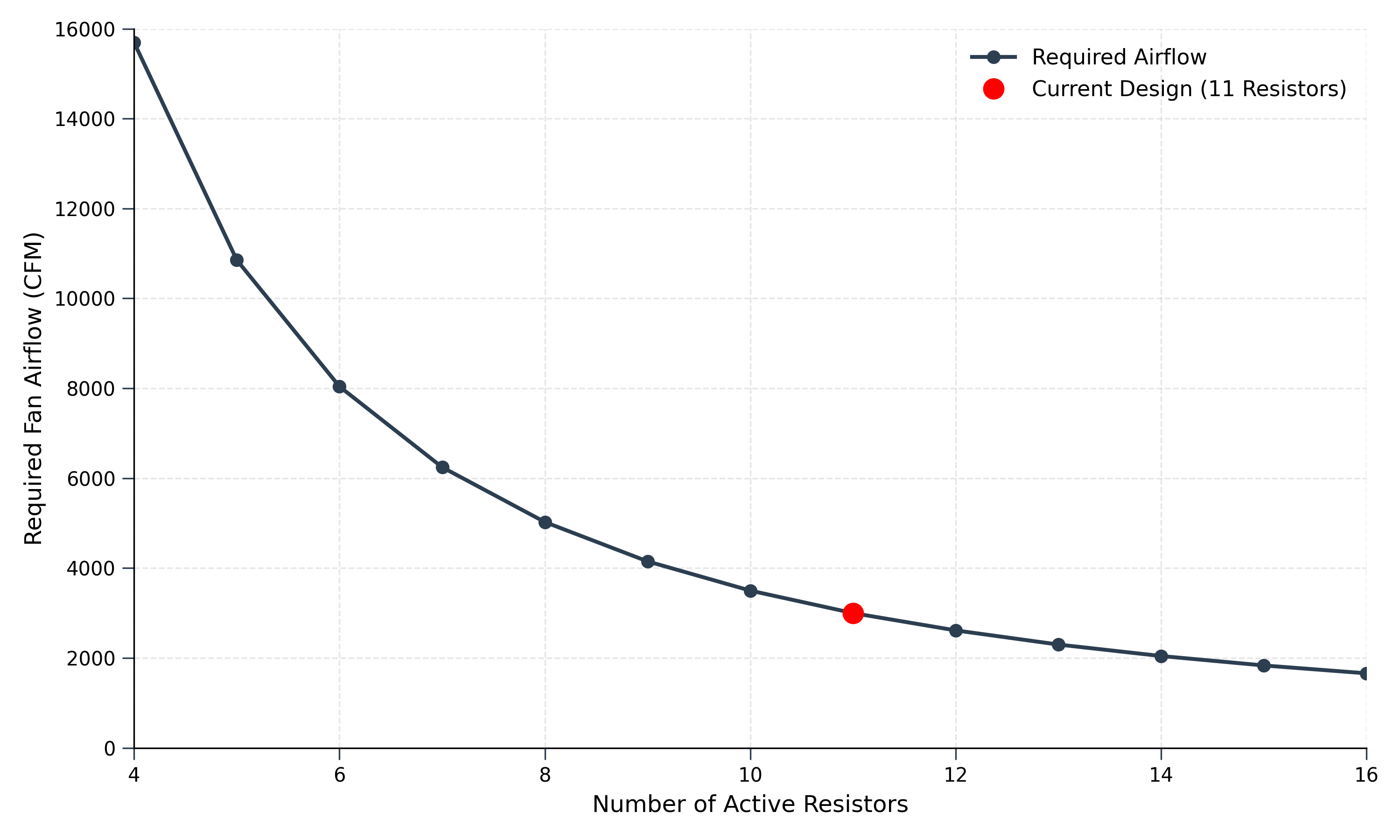
analysis/plots/Sensitivity_2_Resistor_Count.png
