MBDurbin/VRB/analysis/plots/Thermal_Peak_vs_Airflow.png

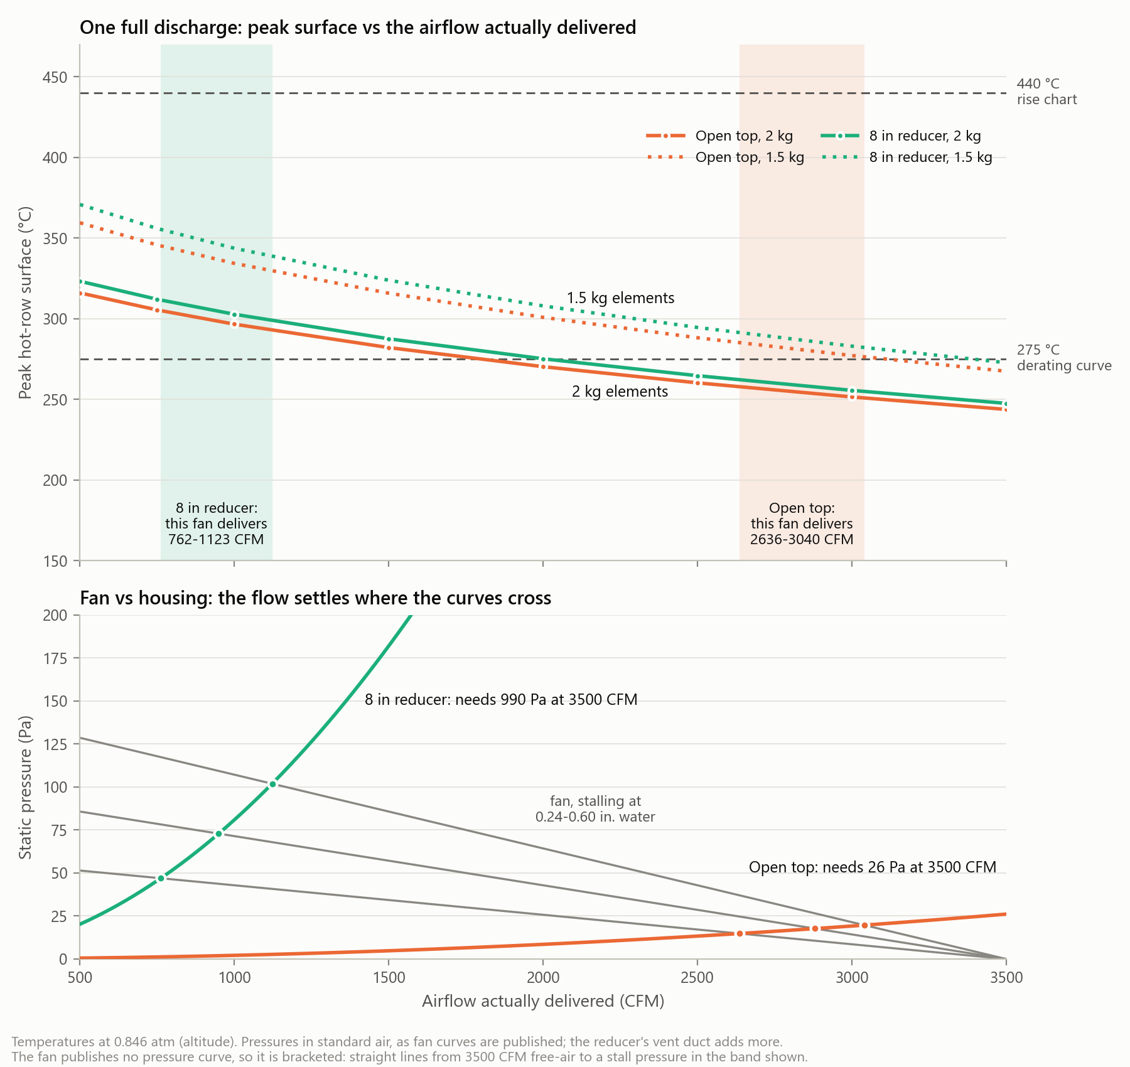
analysis/plots/Thermal_Peak_vs_Airflow.png
