MBDurbin/VRB/analysis/plots/Thermal_Steady_State.png

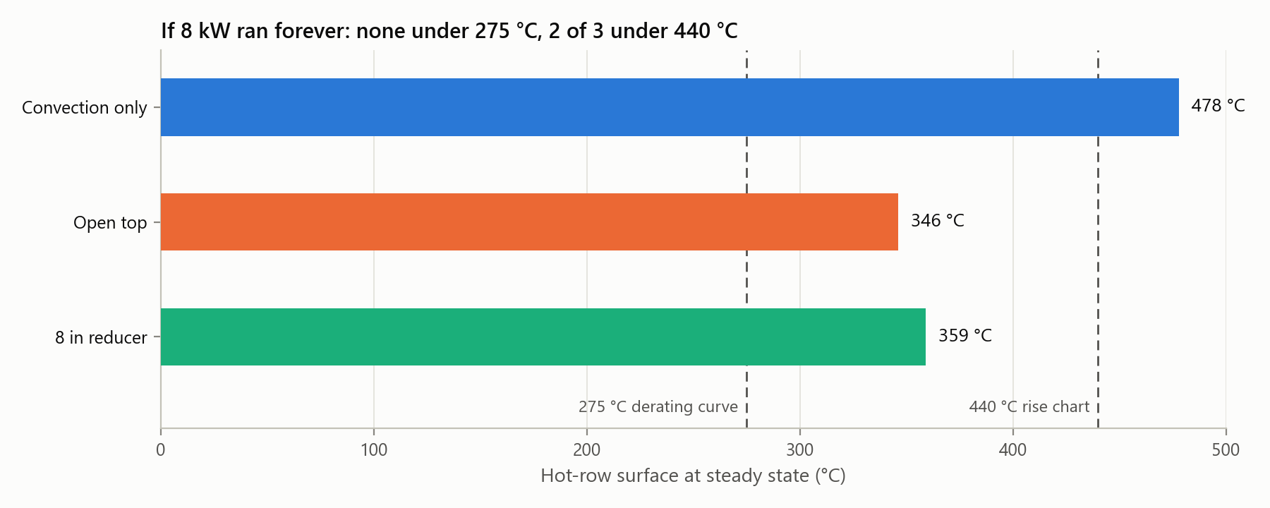
analysis/plots/Thermal_Steady_State.png
