MBDurbin/VRB/analysis/plots/Thermal_Transient_Surface_Temp.png

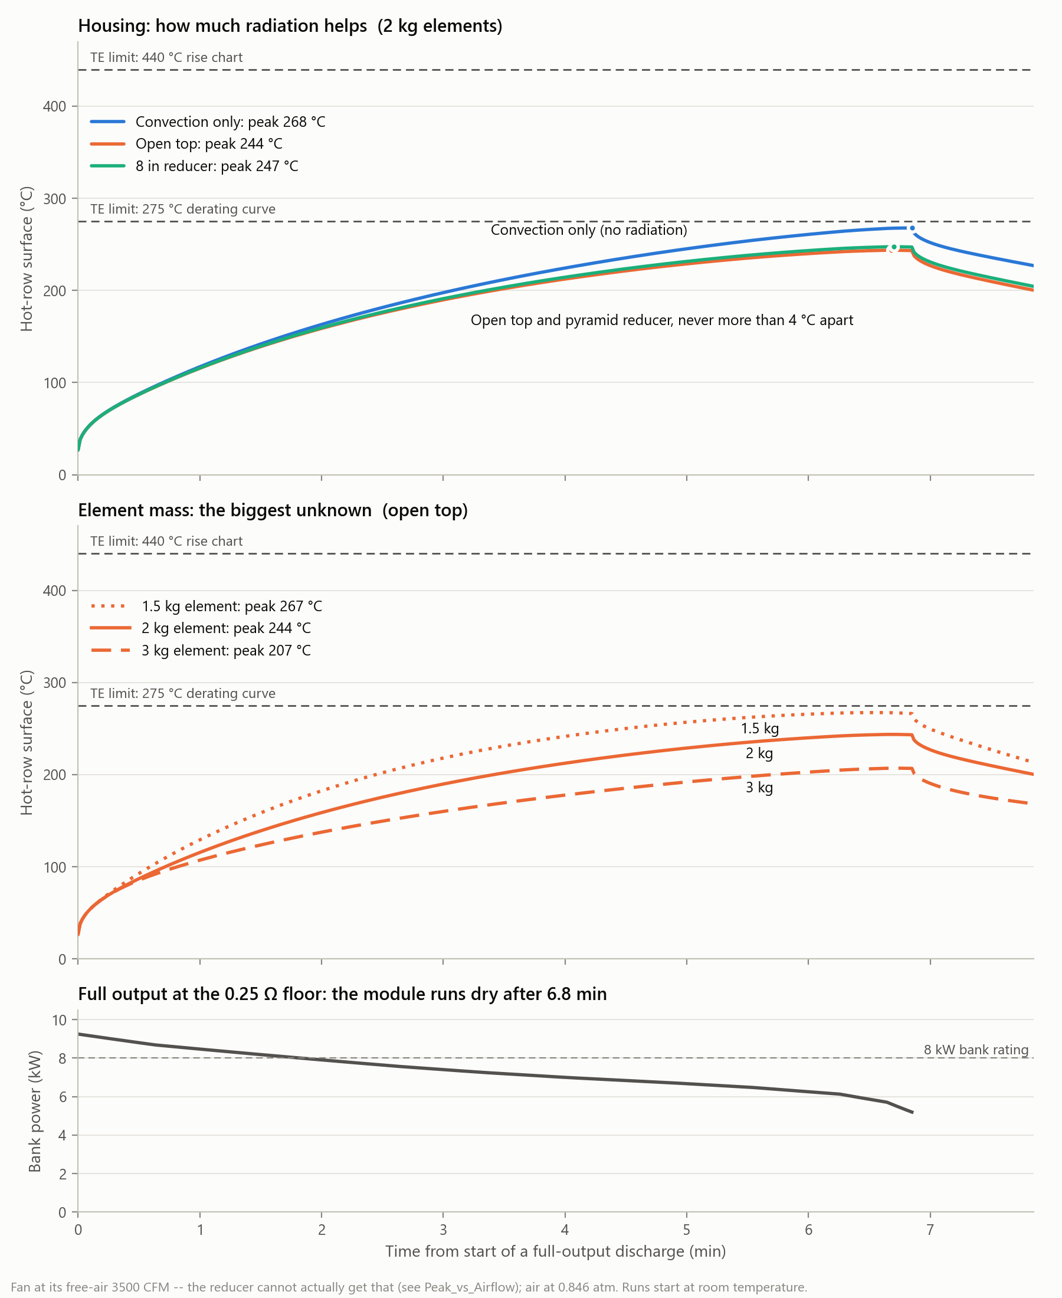
analysis/plots/Thermal_Transient_Surface_Temp.png
