MBDurbin/VRB/tests/SIL_CHECKLIST.md

# SIL Validation Checklist

Manual desk-test procedure for the behavior that unit tests **cannot** cover:
process/queue plumbing, GUI responsiveness, and timing. No battery, DAQ, or
Arduino required — plug in the SIL dongle and run `main_v2.py`.

Unit tests cover the decision math (`pytest`). This covers everything else.

---

## Setup

```bash
python -m pytest
```

All 48 tests must pass before starting. Then plug in the SIL dongle and:

```bash
python main_v2.py
```

The SIL plant models the pack and sensor layout in `rig_config.json`, so the
figures below assume the shipped Reliance RS50 12S4P (12 mΩ module). On another
pack, recompute the sag and trip currents from its resistance.

Confirm the console prints `--> SIL KEY UNLOCKED on COMx` and both the SIL
plant-model window and the main telemetry GUI appear.

---

## A. Baseline pipeline

| # | Step | Expected |
|---|---|---|
| A1 | Observe idle state | State pill reads `DISCONNECTED` (no resistor Arduino in SIL) |
| A2 | Drag the SIL **Simulated Load** slider | Current label + cyan graph track the slider within ~1s |
| A3 | Drag the SIL **Max Temp** slider | Heatmap (SHOW HEATMAP) cells recolor blue→red |
| A4 | Drag the SIL **Pack OCV** slider | Pack voltage label + yellow graph follow; sag grows with load |
| A5 | Let it sit 60s | Voltage/current graphs scroll continuously, no freeze, no console spam |

## B. Safety trips

| # | Step | Expected |
|---|---|---|
| B1 | Raise temp slider past **Max Temp** (default 80 °C, the RS50's cut-off) | State goes `FAULT` (red), console logs `OVERTEMP ALARM!` |
| B2 | While in FAULT, lower temp back to 25 °C | State **stays** `FAULT` — must not self-clear |
| B3 | Press **RESET** | Returns to `IDLE` |
| B4 | Set **Max Amp** to 120 A, then raise current slider past 125 A (Max Amp + E-Stop Buffer) | `FAULT`, console logs `OVERCURRENT ALARM!`. The derived RS50 limit is 280 A, past the slider, and the bank's total power trip (B16) fires first at any limit above ~230 A (~160 A with **Bank at rated power only** ticked) |
| B5 | RESET, then press **E-STOP** with no fault present | Immediately `FAULT` regardless of prior state |
| B6 | RESET, then drag SIL **Pack OCV** down to 3.00 V/cell | `FAULT`, console logs `UNDERVOLTAGE ALARM!` |
| B7 | RESET, set OCV to 3.05 V/cell, then raise current to ~100 A | `FAULT` on sag alone — pack reads 35.4 V under load despite 36.6 V at rest (12 mΩ RS50 module) |
| B8 | With all three faults possible at once (hot + high amps + low OCV) | Console reports `OVERTEMP` — priority is temp > current > bank power > voltage |
| B9 | RESET, ARM, then tick **Simulate hardware interlock fault** | `FAULT` logging `NI-DAQ OFFLINE` — the toggle drops the NI-DAQ and the temperature link together, and the DAQ is reported first because its 0.0 V would otherwise read as undervoltage |
| B10 | Untick the fault, RESET, stay in `IDLE`, tick it again | **No** fault — sensor checks apply only in ARMED/RUNNING, so the rig can still be brought up |
| B11 | RESET, ARM, then set OCV so one cell would read below **Cell min** (2.70 V) | `FAULT` logging `CELL UNDERVOLTAGE` |
| B12 | Start the app with **no battery connected** (0.0 V), leave it in `IDLE` | **No** fault. Voltage checks apply only once armed, so software bring-up is possible without a pack |
| B13 | From B12, press **ARM** | `FAULT` — arming on a 0.0 V reading must not be silently permitted |
| B14 | ARM+RUN, then close the SIL window so the plant stops feeding | `FAULT` logging `DAQ DATA STALE` within ~1 s, and the GUI keeps updating rather than freezing |
| B15 | Repeat B14 but press **E-STOP** while the plant is stopped | E-STOP is still processed — the logic loop no longer skips its body on an empty queue |
| B16 | RESET, tick **Bank at rated power only**, set **Max Amp** to 2000 A (the spinbox maximum), OCV 4.20 V/cell, raise current past ~165 A | `FAULT` logging `BANK OVERPOWER` and `Ladder at ... W (limit 8000 W)` once V × I passes 8 kW, in `IDLE` as well. Console logs `bank power 100% of rating` when the box is ticked. No Max Amp setting moves this trip. 2000 A is past the cells' rating, so `WILL NOT ARM: Over-current trip ...` shows beside the pills until Max Amp is set back |
| B16a | Untick **Bank at rated power only**, RESET, raise current past ~236 A | `FAULT` logging `BANK OVERPOWER` and `Ladder at ... W (limit 11200 W)` once V × I passes 11.2 kW (140%). Console logs `bank power 140% of rating` |
| B17 | RESET, ARM, drag SIL **Bank 1 resistor** past 225 °C | `FAULT` logging `RESISTOR OVERTEMP` and `Bank 1 at ... C (trip 225 C)`. Fires in `IDLE` as well |
| B18 | Open **Resistor Map** while dragging the Bank 1 slider | Bank 1's four top-row elements recolour toward red as they near 225 °C; banks 5–8 read `NO SENSOR` |
| B19 | RESET, tick **Simulate hardware interlock fault** in `IDLE`, press **ARM** | ARM **refused**: state stays `IDLE` (no FAULT, nothing to reset), console logs `Cannot ARM: NI-DAQ OFFLINE`, and `WILL NOT ARM: NI-DAQ OFFLINE` shows in red beside the hardware pills. Untick, press ARM again: `ARMED` |
| B20 | From `IDLE`, **Configure → Battery Pack**, set series count to 14, Save (accept the problems prompt) | Dialog lists the voltage-channel mismatch under `WILL NOT ARM` and the thermistor shortfall under `WARNING`. Main window shows `WILL NOT ARM: 12 voltage channels configured but the pack is 14S ...`; pressing **ARM** is refused. Set it back to 12: the label clears and ARM works |
| B21 | ARM, then repeat B20's change to 14S | `FAULT` logging `CONFIG FAULT` and naming the voltage-channel mismatch — a config change that leaves cells unwatched while armed kills the load |

**Not reachable from the SIL sliders** — the plant model generates uniform cells
and always-fresh timestamps, so these need either a unit test or real hardware:

- `CELL SENSE FAULT` (one cell reading below `cell_sense_floor`, i.e. a pulled
  sense lead). Covered by `test_implausibly_low_reading_is_a_sense_fault_not_undervoltage`.
- `TEMP DATA STALE` (link reports connected but stops sending). B9 exercises the
  link-lost path only. On the bench, pull the temp Arduino's TX line while
  leaving it enumerated to reach this. Covered by `test_stale_data_trips`.
- `RESISTOR TC FAULT` / `NO RESISTOR TEMP DATA` (an open thermocouple, or no thermocouple module). The SIL plant always reports all four banks. On the bench, ARM and unplug one thermocouple: the rig should fault within ~3 s naming that bank. Covered by `test_stale_thermocouple_faults_once_armed`.
- `TEMP SENSOR FAULT` (one DS18B20 reporting `ERR` while the rest of the stream
  stays fresh). On the bench, ARM and then pull one sensor's data lead: the rig
  should fault within ~3 s and the console should name that bus and sensor.
  Covered by `test_one_frozen_sensor_trips_despite_a_fresh_stream`.
- `INVALID READING` / `INCOMPLETE DATA` (NaN or implausible readings, or fewer
  readings than the wiring has). The SIL sliders only produce clean, complete
  packets. Covered by `TestMeasurementIntegrity` and
  `test_nan_current_mid_run_faults_and_kills_the_load`.
- `RESISTOR LINK LOST` (the resistor controller stops taking writes mid-run).
  The SIL rig has no controller to unplug. On the bench, RUN, then pull the
  resistor Arduino's USB: the rig should latch `FAULT` (not `DISCONNECTED`), the
  `RESISTOR CTRL` pill should go offline, and the contactor should open within
  2 s on the Arduino's watchdog. Covered by
  `test_failed_write_mid_run_latches_a_fault_and_drops_the_link`.

## C. FSM transition guards

| # | Step | Expected |
|---|---|---|
| C1 | From `IDLE`, press **RUN** (skipping ARM) | Ignored — state stays `IDLE` |
| C2 | From `IDLE`, press **RESET** | Ignored (RESET is FAULT-only) |
| C3 | ARM → RUN with laps=3 | State `RUNNING`, lap counter reads `Lap: 1 / 3` |
| C4 | While `RUNNING`, press **ARM** | Ignored — no state change |
| C5 | While `RUNNING`, press **E-STOP** | Immediate `FAULT`, lap counter resets to `-- / --` |
| C6 | Let a 1-lap run finish | Auto-returns to `IDLE`, console logs `All 1 laps completed` |

## D. GUI-glitch safety (the important one)

| # | Step | Expected |
|---|---|---|
| D1 | **Type** a new value into `Max Temp` (select-all, type `70`, press Enter) | No fault while typing. Limit applies only on Enter/focus-out (regression test for Risk #1). Keep it at or below the cell's ceiling: past it, the limit itself blocks ARM, and faults a running rig as `CONFIG FAULT` |
| D1a | From `IDLE`, set `Max Temp` past the cell's ceiling (e.g. 100 with RS50 cells), press **ARM** | ARM refused; `WILL NOT ARM: Max temp 100.0 C exceeds the cell's ...` beside the pills. Set it back: the label clears |
| D2 | Rapidly spin `Max Amp` up/down ~30x fast | GUI stays responsive; no queue backlog; limits settle on final value |
| D3 | Immediately after D2, press **E-STOP** | Responds instantly, never freezes (regression test for Risk #2) |
| D4 | Set `Derate Start` above `Max Temp`, enable derate, then RUN | No crash. Logic process stays alive (fail-safe full derate) |
| D5 | Set `Max Amp` to 0, then RUN | No crash, no divide-by-zero |
| D8 | Set `V Crit` to 45 V while running at 4.20 V/cell OCV | Trips `UNDERVOLTAGE` — confirms the spinbox actually reaches the logic process |
| D9 | While `RUNNING`, press **Configure** | Refused with "Run in progress"; nothing changes or saves. The controller ignores a new config mid-run |
| D10 | From `IDLE`, **Configure**, change the cell's max temp, press **Cancel**. Then nudge `E-stop buffer` | Sidebar `Max Temp` is unchanged before and after the nudge, and no `NOT IN FORCE` line appears: the cancelled preview did not leak into the live limits |
| D11 | Drag `V Warn` to a new value | Only the dashed plot line moves. Console shows no `Limits updated`, and after a restart there is no "Hand-edited limits were replaced" dialog |
| D12 | Use the rig normally through C and D | The red `NOT IN FORCE ON THE CONTROLLER` line beside the car and pack label never appears. If it does, the controller is not using the settings shown |
| D6 | Toggle heatmap open/closed 10x while `RUNNING` | No crash, temps keep updating, run continues |
| D7 | Close the heatmap window via its X while `RUNNING` | Main GUI unaffected, run continues |

## E. Recording / logging

| # | Step | Expected |
|---|---|---|
| E1 | START RECORDING, run 1 lap, STOP RECORDING | `logs/telemetry_*.csv` created with 68 columns + header |
| E2 | Open the CSV | Rows are contiguous, SOC decreases monotonically, no blank/garbage rows |
| E3 | START RECORDING then close the GUI without stopping | File closes cleanly, no truncation/corruption |

## F. Shutdown / process hygiene

| # | Step | Expected |
|---|---|---|
| F1 | Close the main GUI while `RUNNING` | All processes exit; console prints `[LOGIC] Process cleanly shutdown.` |
| F2 | Check Task Manager after exit | No orphaned `python.exe` processes left behind |
| F3 | Tick **Trigger Hardware Interlock Fault** on the SIL window | `NI DAQ` + `TEMP SENSOR` pills go OFFLINE (red) |
| F4 | Untick it | Pills return ONLINE (green) |

---

## Fixed GUI-safety risks (steps D1 and D3 are their regression tests)

**Risk #1 — spinbox keystroke could trip a spurious fault. FIXED.**
`create_sidebar_spinbox()` left Qt's default `keyboardTracking=True`, so
`valueChanged` fired on *every keystroke*. Typing `100` into `Max Temp` emitted
`1`, then `10`, then `100` — and the intermediate `1.0` was pushed straight to
the logic process as the live max safe temp, instantly tripping OVERTEMP and
killing the load mid-run. Same hazard on `Max Amp`. Now
`setKeyboardTracking(False)`: the value commits only on Enter/arrows/focus-out.

**Risk #2 — E-STOP button could block the GUI thread. FIXED.**
`gui_cmd_queue` is `Queue(maxsize=10)` and every button used a *blocking*
`.put()`. Spinbox spam (Risk #1 made this worse) could fill those 10 slots while
the logic process was busy — notably during `auto_detect_resistor()`, which
blocks ~2-4s **per COM port** while probing. A full queue meant the E-STOP press
froze the GUI. All commands now route through `send_command_nonblocking()`,
which drops the oldest command rather than blocking. Covered by
`tests/test_gui_dispatch.py`.

**Risk #2b — E-STOP could be dropped by a full queue. FIXED.** Making room in a
full `multiprocessing.Queue` is not guaranteed — `get_nowait()` can raise Empty
for a moment after the queue's own puts — so a STOP pressed into a full queue
could be lost, with heartbeats carrying on so the Arduino watchdog never fired.
E-STOP no longer uses the queue: it sets a latched `estop_event` that the logic
loop takes ahead of every queued command. Covered by `TestEstopSignal` and
`test_estop_gets_through_a_jammed_command_queue`.

**Risk #3 — no undervoltage protection existed at all. FIXED.**
`V Warn` and `V Crit` were wired only to the dashed lines on the voltage plot and
were never placed in `limits_dict`, so they never reached the logic process.
`check_safety_trip` only ever saw temperature and current — nothing stopped a
discharge below the cells' 2.5 V/cell cutoff. `V Crit` now trips a genuine
UNDERVOLTAGE fault (default 36.0 V = 3.0 V/cell, leaving room for sag: 3.4 V
for the RS50 module's 12 mΩ at its 280 A rating, and 8.1 V for the 45 mΩ Molicel
P45B this was first written for). `V Warn` remains display-only and its
label now says so.

### Residual limitation (by design, verify behavior in D3)

Fixing the queue guarantees the **GUI** stays responsive, but the logic process
still cannot *act* on a STOP while it is blocked inside `auto_detect_resistor()`
port scanning. This is acceptable because during a port scan `res_ser` is None —
the resistor Arduino is disconnected, so its own 2s serial watchdog
(`shedAllLoad()`) has already opened the main contactor and shed the load
in hardware. Confirm this on the bench before trusting it: the software E-STOP
and the Arduino watchdog are independent layers and both must work.
