MBDurbin/VRB/tests/test_rig_config.py

"""
Unit tests for the rig configuration layer.

This is safety-relevant: SafetyLimits derives the over-current, over-temp and
undervoltage trip points from the cell datasheet, so a wrong derivation puts
wrong thresholds into the logic process. Also covers persistence, because a
config that fails to round-trip silently reverts a future team's settings.
"""
import json
import math
import os
import sys
import tempfile

sys.path.insert(0, os.path.dirname(os.path.dirname(os.path.abspath(__file__))))

from rig_config import (
    VehicleParams,
    PackConfig,
    SafetyLimits,
    DaqConfig,
    RigConfig,
    field_label,
    DEFAULT_VOLTAGE_CHANNELS,
    DEFAULT_RESISTOR_TC_CHANNELS,
)


# The Molicel INR-21700-P45B v1.2, whose datasheet is in datasheets/. The rig now
# ships configured for the Reliance RS50, but the repo has no RS50 datasheet to
# check figures against, so the datasheet-anchored tests pin the derivation math
# on this explicit P45B pack instead of on whatever the defaults happen to be.
P45B = dict(cell_model="Molicel INR-21700-P45B", cell_capacity_ah=4.5,
            cell_capacity_min_ah=4.3, cell_max_continuous_a=45.0, cell_max_voltage=4.2,
            cell_nominal_voltage=3.6, cell_min_voltage=2.5, cell_max_temp_c=60.0,
            cell_dc_milliohm=15.0, series_count=12, parallel_count=4)


def p45b_pack(**overrides):
    return PackConfig(**{**P45B, **overrides})


# ================= PACK DERIVATION =================

class TestPackDerivation:
    def test_p45b_derives_its_datasheet_figures(self):
        # Molicel INR-21700-P45B v1.2, 12S4P. These are the numbers validated
        # against the datasheet -- if one drifts, the derivation is wrong.
        p = p45b_pack()
        assert p.cell_count == 48
        assert math.isclose(p.capacity_ah, 18.0)          # 4.5 Ah x 4P
        assert math.isclose(p.max_current_a, 180.0)       # 45 A x 4P
        assert math.isclose(p.max_voltage, 50.4)          # 4.2 V x 12S
        assert math.isclose(p.min_voltage, 30.0)          # 2.5 V x 12S
        assert math.isclose(p.nominal_voltage, 43.2)      # 3.6 V x 12S
        assert math.isclose(p.resistance_ohm, 0.045)      # 15 mOhm / 4P x 12S

    def test_parallel_count_scales_current_and_capacity_not_voltage(self):
        p4 = PackConfig(parallel_count=4)
        p6 = PackConfig(parallel_count=6)

        assert math.isclose(p6.max_current_a, p4.max_current_a * 1.5)
        assert math.isclose(p6.capacity_ah, p4.capacity_ah * 1.5)
        assert math.isclose(p6.max_voltage, p4.max_voltage)

    def test_series_count_scales_voltage_not_current(self):
        s12 = PackConfig(series_count=12)
        s14 = PackConfig(series_count=14)

        assert math.isclose(s14.max_voltage, s12.max_voltage * 14 / 12)
        assert math.isclose(s14.max_current_a, s12.max_current_a)

    def test_module_count_scales_battery_voltage_not_current(self):
        # These describe the CAR's battery. The bench loads one module only --
        # they are reference figures, not anything the bank sees.
        p = PackConfig(modules_in_series=9)
        assert p.battery_cell_count == 48 * 9
        assert math.isclose(p.battery_max_voltage, p.max_voltage * 9)
        assert math.isclose(p.battery_min_voltage, p.min_voltage * 9)
        assert math.isclose(p.battery_resistance_ohm, p.resistance_ohm * 9)
        assert math.isclose(p.battery_energy_wh, p.energy_wh * 9)
        # Series modules share current, so the current limit is unchanged.
        assert math.isclose(p.max_current_a, PackConfig(modules_in_series=1).max_current_a)

    def test_single_module_battery_equals_module(self):
        p = PackConfig(modules_in_series=1)
        assert math.isclose(p.battery_max_voltage, p.max_voltage)
        assert p.battery_cell_count == p.cell_count

    def test_internal_resistance_series_adds_parallel_divides(self):
        p = PackConfig(series_count=10, parallel_count=5, cell_dc_milliohm=20.0)
        # 20 mOhm / 5P = 4 mOhm per block, x10S = 40 mOhm
        assert math.isclose(p.resistance_ohm, 0.040)

    def test_minimum_capacity_option_is_more_conservative(self):
        typical = p45b_pack(use_minimum_capacity=False)
        minimum = p45b_pack(use_minimum_capacity=True)

        assert minimum.capacity_ah < typical.capacity_ah
        assert math.isclose(minimum.capacity_ah, 17.2)  # 4.3 Ah x 4P

    def test_sag_matches_ohms_law(self):
        p = p45b_pack()
        assert math.isclose(p.sag_volts(180.0), 180.0 * 0.045)

    def test_voltage_under_load_reproduces_the_sag_hazard(self):
        # A pack resting at a healthy-looking 3.2 V/cell is pushed under the
        # 2.5 V/cell cutoff while loaded. This is why the trip sits above 30 V.
        # Needs the P45B's 45 mOhm module; a low-resistance cell sags far less.
        p = p45b_pack()
        loaded = p.voltage_under_load(ocv_per_cell=3.2, current_a=187.0)
        assert loaded < p.min_voltage
        assert math.isclose(loaded / p.series_count, 2.499, abs_tol=0.001)

    def test_suggested_min_voltage_is_above_absolute_cutoff(self):
        p = PackConfig()
        assert p.suggested_min_voltage() > p.min_voltage
        assert math.isclose(p.suggested_min_voltage(), 36.0)


# ================= LIMIT DERIVATION =================

class TestLimitDerivation:
    def test_derives_from_pack_by_default(self):
        # Whatever cell the rig ships configured for.
        pack = PackConfig()
        limits = SafetyLimits().apply_pack_derivation(pack)

        # Operating limit sits a buffer below the rating so the E-STOP, which
        # fires at max_amps + buffer, lands exactly ON the rating.
        assert math.isclose(limits.max_amps + limits.amp_buffer, pack.max_current_a)
        assert math.isclose(limits.max_temp, pack.cell_max_temp_c)
        assert math.isclose(limits.min_volts, 3.0 * pack.series_count)

    def test_p45b_derives_its_datasheet_limits(self):
        limits = SafetyLimits().apply_pack_derivation(p45b_pack())
        assert math.isclose(limits.max_amps, 175.0)     # 180 A rating, less the 5 A buffer
        assert math.isclose(limits.max_temp, 60.0)      # discharge ceiling, not the 80 C cut-off
        assert math.isclose(limits.min_volts, 36.0)     # 3.0 V x 12S

    def test_trip_point_never_exceeds_pack_rating(self):
        for buffer in [0.0, 5.0, 20.0, 100.0]:
            pack = PackConfig()
            limits = SafetyLimits(amp_buffer=buffer).apply_pack_derivation(pack)
            assert limits.max_amps + limits.amp_buffer <= pack.max_current_a + 1e-9

    def test_absurd_buffer_cannot_drive_limit_to_zero(self):
        pack = PackConfig()
        limits = SafetyLimits(amp_buffer=500.0).apply_pack_derivation(pack)
        assert limits.max_amps > 0

    def test_derivation_follows_a_different_cell(self):
        # A future team's cell: 30 A/cell, 55 C ceiling, 20S6P.
        pack = PackConfig(cell_max_continuous_a=30.0, cell_max_temp_c=55.0,
                          parallel_count=6, series_count=20)
        limits = SafetyLimits(amp_buffer=5.0).apply_pack_derivation(pack)

        assert math.isclose(limits.max_amps, 175.0)  # 30 A x 6P = 180, less 5 buffer
        assert math.isclose(limits.max_temp, 55.0)
        assert math.isclose(limits.min_volts, 60.0)  # 3.0 V x 20S

    def test_derivation_is_skipped_when_disabled(self):
        pack = PackConfig()
        limits = SafetyLimits(derive_from_pack=False, max_amps=99.0, max_temp=42.0)
        limits.apply_pack_derivation(pack)

        assert math.isclose(limits.max_amps, 99.0)
        assert math.isclose(limits.max_temp, 42.0)

    def test_derate_start_kept_below_ceiling(self):
        # Derate range must stay positive or the ramp cannot compute.
        pack = PackConfig(cell_max_temp_c=50.0)
        limits = SafetyLimits(derate_start=55.0).apply_pack_derivation(pack)
        assert limits.derate_start < limits.max_temp

    def test_command_dict_shape_matches_logic_process(self):
        # evaluate_safety indexes these directly, so a missing key is a KeyError
        # inside the safety-critical loop rather than a silently skipped check.
        keys = set(SafetyLimits().to_command_dict())
        assert keys == {'max_amps', 'amp_buffer', 'max_temp', 'min_volts',
                        'min_cell_volts', 'cell_sense_floor', 'temp_stale_timeout',
                        'daq_stale_timeout', 'derate_en', 'derate_start',
                        'resistor_max_temp', 'bank_rated_only'}

    def test_per_cell_trip_derives_above_cell_cutoff(self):
        pack = PackConfig()
        limits = SafetyLimits().apply_pack_derivation(pack)
        assert limits.min_cell_volts > pack.cell_min_voltage

    def test_per_cell_trip_below_cutoff_is_flagged(self):
        pack = PackConfig()
        limits = SafetyLimits(derive_from_pack=False, min_cell_volts=2.0,
                              amp_buffer=0.0, max_amps=180.0, max_temp=60.0,
                              min_volts=36.0)
        assert any("Per-cell trip" in w for w in limits.exceedances(pack))

    def test_non_positive_stale_timeout_blocks_arm(self):
        # It switches a monitor off rather than moving a trip, so it is an ARM
        # blocker, not an exceedance.
        cfg = RigConfig.defaults()
        cfg.limits.temp_stale_timeout_s = 0.0
        assert any("staleness" in p for p in cfg.arm_blockers())
        assert not any("staleness" in w for w in cfg.limits.exceedances(cfg.pack))


# ================= DERIVATION CONFLICTS =================

class TestDerivationConflicts:
    """Derivation is authoritative, but must never discard an edit silently."""

    def test_untouched_config_reports_nothing(self):
        pack = PackConfig()
        limits = SafetyLimits().apply_pack_derivation(pack)
        assert limits.derivation_conflicts(pack) == []

    def test_hand_edited_limit_is_reported(self):
        pack = PackConfig()
        limits = SafetyLimits(max_amps=120.0)      # engineer derates
        conflicts = limits.derivation_conflicts(pack)

        names = {c[0] for c in conflicts}
        assert 'max_amps' in names
        loaded, derived = next((lo, d) for n, lo, d in conflicts if n == 'max_amps')
        assert loaded == 120.0
        assert derived == pack.max_current_a - SafetyLimits().amp_buffer

    def test_reversion_can_be_in_the_unsafe_direction(self):
        # The reason this warning exists: a deliberate derate coming back higher.
        pack = PackConfig()
        limits = SafetyLimits(max_amps=120.0)
        _, loaded, derived = next(c for c in limits.derivation_conflicts(pack)
                                  if c[0] == 'max_amps')
        assert derived > loaded

    def test_nothing_reported_when_derivation_is_off(self):
        pack = PackConfig()
        limits = SafetyLimits(derive_from_pack=False, max_amps=120.0)
        assert limits.derivation_conflicts(pack) == []

    def test_conflicts_do_not_mutate_the_limits(self):
        # Probing must not apply the derivation as a side effect.
        pack = PackConfig()
        limits = SafetyLimits(max_amps=120.0)
        limits.derivation_conflicts(pack)
        assert limits.max_amps == 120.0

    def test_every_derived_field_is_covered(self):
        # If apply_pack_derivation gains a field, DERIVED_FIELDS must too, or
        # that field would start reverting silently again.
        pack = PackConfig(series_count=14, parallel_count=6, cell_max_temp_c=55.0,
                          cell_min_voltage=2.8)
        limits = SafetyLimits()
        before = {f: getattr(limits, f) for f in SafetyLimits.DERIVED_FIELDS}
        limits.apply_pack_derivation(pack)

        changed = {f for f in before if abs(before[f] - getattr(limits, f)) > 1e-9}
        assert changed, "expected this pack to move several derived limits"
        assert changed <= set(SafetyLimits.DERIVED_FIELDS)

    def test_load_surfaces_conflicts_on_the_config(self):
        raw = RigConfig.defaults().to_dict()
        raw['limits']['max_amps'] = 120.0
        cfg = RigConfig.from_dict(raw)
        assert any(c[0] == 'max_amps' for c in cfg.discarded_limits)

    def test_conflicts_never_reach_the_saved_file(self):
        raw = RigConfig.defaults().to_dict()
        raw['limits']['max_amps'] = 120.0
        cfg = RigConfig.from_dict(raw)
        assert cfg.discarded_limits           # present in memory
        assert set(cfg.to_dict()) == {'vehicle', 'pack', 'limits', 'daq'}

    def test_pack_change_still_redderives(self):
        # The behaviour the warning must not regress: a bigger pack still moves
        # the limits, rather than inheriting the old pack's ceiling.
        raw = RigConfig.defaults().to_dict()
        raw['pack']['parallel_count'] = 8
        cfg = RigConfig.from_dict(raw)
        assert math.isclose(cfg.limits.max_amps + cfg.limits.amp_buffer,
                            cfg.pack.cell_max_continuous_a * 8)


# ================= EXCEEDANCE WARNINGS =================

class TestExceedances:
    def test_derived_defaults_are_clean(self):
        pack = PackConfig()
        limits = SafetyLimits().apply_pack_derivation(pack)
        assert limits.exceedances(pack) == []

    def test_buffer_pushing_trip_over_rating_is_flagged(self):
        # The E-STOP fires at max_amps + buffer, so a limit exactly at the
        # rating still trips over it. This is the 182/187 A bug, generalised.
        pack = PackConfig()
        limits = SafetyLimits(derive_from_pack=False, max_amps=pack.max_current_a,
                              amp_buffer=5.0)
        warnings = limits.exceedances(pack)
        assert any("exceeds" in w and "A" in w for w in warnings)

    def test_zero_buffer_at_rating_is_clean(self):
        pack = PackConfig()
        limits = SafetyLimits(derive_from_pack=False, max_amps=pack.max_current_a,
                              amp_buffer=0.0)
        assert not any("pack rating" in w for w in limits.exceedances(pack))

    def test_overtemp_limit_is_flagged(self):
        pack = PackConfig()
        limits = SafetyLimits(derive_from_pack=False, max_temp=pack.cell_max_temp_c + 5.0,
                              amp_buffer=0.0, max_amps=pack.max_current_a, min_volts=36.0)
        assert any("discharge ceiling" in w for w in limits.exceedances(pack))

    def test_undervoltage_below_absolute_cutoff_is_flagged(self):
        pack = PackConfig()
        limits = SafetyLimits(derive_from_pack=False, min_volts=28.0, amp_buffer=0.0,
                              max_amps=180.0, max_temp=60.0)
        assert any("absolute cutoff" in w for w in limits.exceedances(pack))

    def test_impossible_derate_range_is_flagged(self):
        pack = PackConfig()
        limits = SafetyLimits(derive_from_pack=False, derate_enabled=True,
                              derate_start=60.0, max_temp=60.0, amp_buffer=0.0,
                              max_amps=180.0, min_volts=36.0)
        # An advisory: resistance_floor() fails safe to full derate.
        assert any("derate" in w.lower() for w in limits.advisories())
        assert not any("derate" in w.lower() for w in limits.exceedances(pack))


# ================= PERSISTENCE =================

class TestPersistence:
    def test_round_trip_preserves_values(self):
        cfg = RigConfig.defaults()
        cfg.vehicle.mass_car_kg = 245.5
        cfg.vehicle.drag_coefficient = 0.42
        cfg.pack.cell_model = "Samsung INR21700-50E"
        cfg.pack.parallel_count = 6

        with tempfile.TemporaryDirectory() as d:
            path = os.path.join(d, "cfg.json")
            cfg.save(path)
            loaded = RigConfig.load(path)

        assert math.isclose(loaded.vehicle.mass_car_kg, 245.5)
        assert math.isclose(loaded.vehicle.drag_coefficient, 0.42)
        assert loaded.pack.cell_model == "Samsung INR21700-50E"
        assert loaded.pack.parallel_count == 6

    def test_missing_file_falls_back_to_defaults(self):
        with tempfile.TemporaryDirectory() as d:
            loaded = RigConfig.load(os.path.join(d, "nope.json"))
        assert loaded.pack == PackConfig()

    def test_corrupt_file_falls_back_rather_than_crashing(self):
        # A broken config must never stop the rig from starting.
        with tempfile.TemporaryDirectory() as d:
            path = os.path.join(d, "bad.json")
            with open(path, 'w') as fh:
                fh.write("{ this is not json")
            loaded = RigConfig.load(path)
        assert loaded.pack == PackConfig()

    def test_unknown_keys_are_ignored(self):
        # Forward compatibility: a config from a newer version still loads.
        raw = RigConfig.defaults().to_dict()
        raw['pack']['some_future_field'] = 123
        raw['vehicle']['another_one'] = "x"
        loaded = RigConfig.from_dict(raw)
        assert loaded.pack == PackConfig()

    def test_missing_keys_fall_back_to_field_defaults(self):
        loaded = RigConfig.from_dict({'pack': {'parallel_count': 8}})
        default_cell_amps = PackConfig().cell_max_continuous_a
        assert loaded.pack.parallel_count == 8
        assert math.isclose(loaded.pack.cell_max_continuous_a, default_cell_amps)
        assert math.isclose(loaded.pack.max_current_a, default_cell_amps * 8)

    def test_empty_dict_yields_defaults(self):
        loaded = RigConfig.from_dict({})
        assert math.isclose(loaded.vehicle.total_mass_kg, 330.0)

    def test_loading_redderives_limits_for_changed_pack(self):
        # Someone edits the JSON to a bigger pack; limits must follow, not
        # silently keep the old pack's current ceiling.
        raw = RigConfig.defaults().to_dict()
        raw['pack']['parallel_count'] = 8
        loaded = RigConfig.from_dict(raw)
        assert math.isclose(loaded.limits.max_amps + loaded.limits.amp_buffer,
                            loaded.pack.cell_max_continuous_a * 8)

    def test_saved_file_is_readable_json(self):
        with tempfile.TemporaryDirectory() as d:
            path = os.path.join(d, "cfg.json")
            RigConfig.defaults().save(path)
            with open(path) as fh:
                raw = json.load(fh)
        assert set(raw) == {'vehicle', 'pack', 'limits', 'daq'}


# ================= DAQ CONFIG =================

class TestDaqConfig:
    def test_defaults_match_the_12s_wiring(self):
        d = DaqConfig()
        assert d.channel_count == 12
        assert d.sensor_count == 48        # 6 buses x 8 sensors
        assert d.temp_fields_per_line == 9  # bus number + 8 readings

    def test_default_wiring_validates_against_default_pack(self):
        assert DaqConfig().validate(PackConfig()) == []

    def test_channel_count_mismatch_is_reported(self):
        # 12 channels wired, but the pack was reconfigured to 14S.
        problems = DaqConfig().validate(PackConfig(series_count=14))
        assert any("voltage channels" in p for p in problems)

    def test_sensor_count_mismatch_is_reported(self):
        # 48 thermistors cannot cover a 14S5P (70 cell) pack.
        problems = DaqConfig(voltage_channels=[f"ch{i}" for i in range(14)]).validate(
            PackConfig(series_count=14, parallel_count=5))
        assert any("thermistors" in p for p in problems)

    def test_current_channel_colliding_with_voltage_is_reported(self):
        d = DaqConfig(current_channel="cDAQ1Mod8/ai1")
        assert any("also listed" in p for p in d.validate(PackConfig()))

    def test_duplicate_voltage_channels_are_reported(self):
        chans = list(DaqConfig().voltage_channels)
        chans[5] = chans[0]
        assert any("Duplicate" in p for p in DaqConfig(voltage_channels=chans).validate(PackConfig()))

    def test_non_positive_sample_period_is_reported(self):
        assert any("Sample period" in p for p in DaqConfig(sample_period_s=0.0).validate(PackConfig()))

    def test_matching_custom_wiring_validates_clean(self):
        # A future team's 14S5P rig, correctly wired: 14 taps, 70 thermistors.
        # The taps fill modules 1-4, so the resistor thermocouples move off
        # their default module 3.
        pack = PackConfig(series_count=14, parallel_count=5)
        daq = DaqConfig(
            voltage_channels=[f"cDAQ1Mod{1 + i // 4}/ai{i % 4}" for i in range(14)],
            temp_bus_count=10, sensors_per_bus=7,
            resistor_tc_channels=[f"cDAQ1Mod9/ai{i}" for i in range(4)],
        )
        assert daq.validate(pack) == []
        assert daq.sensor_count == pack.cell_count

    def test_default_factory_does_not_share_state(self):
        # A mutable default would let one config's edits leak into another.
        a, b = DaqConfig(), DaqConfig()
        a.voltage_channels.append("cDAQ1Mod9/ai0")
        assert len(b.voltage_channels) == 12

    def test_channel_list_survives_round_trip(self):
        cfg = RigConfig.defaults()
        cfg.daq.voltage_channels = ["a/ai0", "b/ai1", "c/ai2"]
        loaded = RigConfig.from_dict(cfg.to_dict())
        assert loaded.daq.voltage_channels == ["a/ai0", "b/ai1", "c/ai2"]

    def test_config_without_daq_section_gets_defaults(self):
        # Configs written before the DAQ section existed must still load.
        loaded = RigConfig.from_dict({'pack': {'series_count': 12}})
        assert loaded.daq.channel_count == 12

    def test_top_level_validate_covers_limits_and_daq(self):
        cfg = RigConfig.defaults()
        cfg.pack.series_count = 14      # now disagrees with the 12 channels
        cfg.limits.max_temp = 999.0     # and exceeds the cell rating
        problems = cfg.validate()
        assert any("voltage channels" in p for p in problems)
        assert any("discharge ceiling" in p for p in problems)


# ================= GUI FIELD LABELS =================

class TestFieldLabels:
    def test_known_field_has_label_and_unit(self):
        label, unit = field_label('mass_car_kg', {'mass_car_kg': ("Car mass", "kg")})
        assert label == "Car mass"
        assert unit == "kg"

    def test_unknown_field_falls_back_to_prettified_name(self):
        label, unit = field_label('some_new_param', {})
        assert label == "Some new param"
        assert unit == ""


# ================= RESISTOR THERMOCOUPLES AND TRIPS =================

class TestResistorTrips:
    def test_defaults_cover_the_four_thermocoupled_banks(self):
        limits = SafetyLimits()
        assert len(limits.resistor_max_temp_c) == len(DaqConfig().resistor_tc_channels) == 4

    def test_te_banks_trip_below_the_element_rating(self):
        # TE2000: 275 C element limit (derating curve zero-load point).
        assert all(t < 275.0 for t in SafetyLimits().resistor_max_temp_c[:3])

    def test_quoted_numbers_in_the_json_become_floats(self):
        limits = SafetyLimits(resistor_max_temp_c=["200", 210])
        assert limits.resistor_max_temp_c == [200.0, 210.0]

    def test_garbage_trip_makes_load_fall_back_rather_than_reach_the_loop(self, tmp_path):
        raw = RigConfig.defaults().to_dict()
        raw['limits']['resistor_max_temp_c'] = ["hot", 200.0]
        path = tmp_path / "rig_config.json"
        path.write_text(json.dumps(raw), encoding="utf-8")
        assert RigConfig.load(str(path)).limits.resistor_max_temp_c == \
            SafetyLimits().resistor_max_temp_c

    def test_trip_above_element_rating_is_flagged(self):
        limits = SafetyLimits(resistor_max_temp_c=[300.0, 225.0, 225.0, 150.0])
        assert any("Bank 1 resistor trip" in w for w in limits.exceedances(PackConfig()))

    def test_bank_4_has_no_rating_to_flag_against(self):
        limits = SafetyLimits(resistor_max_temp_c=[225.0, 225.0, 225.0, 900.0])
        assert not any("Bank 4" in w for w in limits.exceedances(PackConfig()))

    def test_pack_derivation_never_touches_resistor_trips(self):
        limits = SafetyLimits(resistor_max_temp_c=[100.0, 110.0, 120.0, 90.0])
        limits.apply_pack_derivation(PackConfig(cell_max_temp_c=45.0))
        assert limits.resistor_max_temp_c == [100.0, 110.0, 120.0, 90.0]

    def test_mismatched_channel_and_trip_counts_are_reported(self):
        cfg = RigConfig.defaults()
        cfg.limits.resistor_max_temp_c = [225.0, 225.0]
        assert any("thermocouple channel" in p for p in cfg.validate())

    def test_round_trips_through_the_file(self, tmp_path):
        cfg = RigConfig.defaults()
        cfg.limits.resistor_max_temp_c = [200.0, 205.0, 210.0, 140.0]
        cfg.daq.resistor_tc_channels = ["cDAQ1Mod4/ai0", "cDAQ1Mod4/ai1"]
        path = cfg.save(str(tmp_path / "rig_config.json"))
        loaded = RigConfig.load(path)
        assert loaded.limits.resistor_max_temp_c == [200.0, 205.0, 210.0, 140.0]
        assert loaded.daq.resistor_tc_channels == ["cDAQ1Mod4/ai0", "cDAQ1Mod4/ai1"]

    def test_bad_thermocouple_settings_are_reported(self):
        pack = PackConfig()
        assert any("Thermocouple type" in p for p in DaqConfig(thermocouple_type="Q").validate(pack))
        assert any("Cold-junction" in p
                   for p in DaqConfig(resistor_tc_cjc_source="GUESS").validate(pack))

    def test_thermocouple_on_a_voltage_input_is_reported(self):
        daq = DaqConfig(resistor_tc_channels=["cDAQ1Mod8/ai1", "cDAQ1Mod3/ai1"])
        assert any("also used" in p for p in daq.validate(PackConfig()))

    def test_duplicate_thermocouple_channels_are_reported(self):
        daq = DaqConfig(resistor_tc_channels=["cDAQ1Mod3/ai0", "cDAQ1Mod3/ai0"])
        assert any("Duplicate thermocouple" in p for p in daq.validate(PackConfig()))


# ================= ARM BLOCKERS VS ADVISORIES =================

def _blocked_by(**daq_overrides):
    cfg = RigConfig.defaults()
    for name, value in daq_overrides.items():
        setattr(cfg.daq, name, value)
    return cfg.arm_blockers()


class TestArmBlockers:
    """Configuration problems that leave part of the module or bank unwatched
    block ARM. Everything else is an advisory: shown, never blocking."""

    def test_defaults_are_clean(self):
        cfg = RigConfig.defaults()
        assert cfg.arm_blockers() == []
        assert cfg.advisories() == []

    def test_voltage_channel_count_mismatch_blocks(self):
        assert any("voltage channels" in p
                   for p in _blocked_by(voltage_channels=DEFAULT_VOLTAGE_CHANNELS[:11]))
        # Extra taps block too: the per-cell readings no longer line up.
        extra = DEFAULT_VOLTAGE_CHANNELS + ["cDAQ1Mod4/ai0"]
        assert any("voltage channels" in p for p in _blocked_by(voltage_channels=extra))

    def test_temperature_sensor_shortfall_is_only_advisory(self):
        # By choice: a rig still being instrumented must be able to arm.
        cfg = RigConfig.defaults()
        cfg.daq.sensors_per_bus = 7
        assert cfg.arm_blockers() == []
        assert any("no temperature sensor" in p for p in cfg.advisories())

    def test_temperature_sensor_surplus_is_only_advisory(self):
        cfg = RigConfig.defaults()
        cfg.daq.sensors_per_bus = 9
        assert cfg.arm_blockers() == []
        assert any("thermistors configured" in p for p in cfg.advisories())

    def test_current_on_a_voltage_channel_blocks(self):
        assert any("also listed" in p
                   for p in _blocked_by(current_channel=DEFAULT_VOLTAGE_CHANNELS[3]))

    def test_duplicate_voltage_channel_blocks(self):
        chans = list(DEFAULT_VOLTAGE_CHANNELS)
        chans[5] = chans[0]
        assert any("Duplicate voltage" in p for p in _blocked_by(voltage_channels=chans))

    def test_thermocouple_problems_block(self):
        assert any("also used" in p for p in _blocked_by(
            resistor_tc_channels=[DEFAULT_VOLTAGE_CHANNELS[0]] + DEFAULT_RESISTOR_TC_CHANNELS[1:]))
        assert any("Duplicate thermocouple" in p for p in _blocked_by(
            resistor_tc_channels=[DEFAULT_RESISTOR_TC_CHANNELS[0]] * 4))
        assert any("Thermocouple type" in p for p in _blocked_by(thermocouple_type="Q"))
        assert any("Cold-junction" in p for p in _blocked_by(resistor_tc_cjc_source="GUESS"))

    def test_no_thermocouples_is_only_advisory(self):
        # The runtime check still faults an armed rig with no thermocouple data.
        cfg = RigConfig.defaults()
        cfg.daq.resistor_tc_channels = []
        cfg.limits.resistor_max_temp_c = []
        assert cfg.arm_blockers() == []
        assert any("No resistor thermocouple" in p for p in cfg.advisories())

    def test_bank_with_a_trip_but_no_thermocouple_is_only_advisory(self):
        cfg = RigConfig.defaults()
        cfg.daq.resistor_tc_channels = DEFAULT_RESISTOR_TC_CHANNELS[:3]
        assert cfg.arm_blockers() == []
        assert any("bank(s) 4-4" in p for p in cfg.advisories())

    def test_thermocouple_without_its_own_trip_is_only_advisory(self):
        # Held to the strictest trip, so nothing is unwatched.
        cfg = RigConfig.defaults()
        cfg.limits.resistor_max_temp_c = [225.0, 225.0, 225.0]
        assert cfg.arm_blockers() == []
        assert any("thermocouple channel" in p for p in cfg.advisories())

    def test_non_positive_scaling_blocks(self):
        assert any("Divider multiplier" in p for p in _blocked_by(voltage_multiplier=0.0))
        assert any("Current transducer" in p for p in _blocked_by(current_amps_per_volt=-100.0))
        assert any("Divider multiplier" in p
                   for p in _blocked_by(voltage_multiplier=float('nan')))

    def test_non_positive_daq_stale_timeout_blocks(self):
        cfg = RigConfig.defaults()
        cfg.limits.daq_stale_timeout_s = 0.0
        assert any("DAQ staleness" in p for p in cfg.arm_blockers())

    def test_limits_past_a_rating_block(self):
        # Each fires only after the damage is done. These used to be warnings,
        # so the sidebar could arm the rig with any of them.
        for name, value, words in (
                ('max_amps', 2000.0, "pack rating"),
                ('max_temp', 150.0, "discharge ceiling"),
                ('min_volts', 0.0, "absolute cutoff"),
                ('min_cell_volts', 0.0, "Per-cell trip")):
            cfg = RigConfig.defaults()
            cfg.limits.derive_from_pack = False
            setattr(cfg.limits, name, value)
            assert any(words in p for p in cfg.arm_blockers()), name
            assert not any(words in p for p in cfg.advisories()), name

        cfg = RigConfig.defaults()
        cfg.limits.resistor_max_temp_c = [300.0, 225.0, 225.0, 150.0]
        assert any("Bank 1 resistor trip" in p for p in cfg.arm_blockers())

    def test_limits_at_their_ratings_are_clean(self):
        # The pack-derived limits sit exactly on the ratings.
        assert RigConfig.defaults().arm_blockers() == []

    def test_non_finite_limit_blocks(self):
        # NaN loses every comparison: a NaN max temp could never trip.
        for name in ('max_amps', 'max_temp', 'min_volts', 'min_cell_volts', 'amp_buffer'):
            cfg = RigConfig.defaults()
            cfg.limits.derive_from_pack = False
            setattr(cfg.limits, name, float('nan'))
            assert any("not finite" in p and name in p for p in cfg.arm_blockers()), name
        cfg = RigConfig.defaults()
        cfg.limits.resistor_max_temp_c = [225.0, float('inf'), 225.0, 150.0]
        assert any("resistor_max_temp" in p for p in cfg.arm_blockers())

    def test_quoted_limit_in_the_file_becomes_a_number(self, tmp_path):
        raw = RigConfig.defaults().to_dict()
        raw['limits'].update(derive_from_pack=False, max_temp="60")
        path = tmp_path / "rig_config.json"
        path.write_text(json.dumps(raw), encoding="utf-8")
        assert RigConfig.load(str(path)).limits.max_temp == 60.0

    def test_unreadable_limit_in_the_file_falls_back_to_defaults(self, tmp_path):
        raw = RigConfig.defaults().to_dict()
        raw['limits'].update(derive_from_pack=False, max_temp="hot")
        path = tmp_path / "rig_config.json"
        path.write_text(json.dumps(raw), encoding="utf-8")
        assert RigConfig.load(str(path)).limits.max_temp == RigConfig.defaults().limits.max_temp

    def test_sample_period_is_only_advisory(self):
        cfg = RigConfig.defaults()
        cfg.daq.sample_period_s = 0.0
        assert cfg.arm_blockers() == []
        assert any("Sample period" in p for p in cfg.advisories())

    def test_validate_lists_blockers_first(self):
        cfg = RigConfig.defaults()
        cfg.daq.sample_period_s = 0.0                                   # advisory
        cfg.daq.voltage_channels = DEFAULT_VOLTAGE_CHANNELS[:11]        # blocker
        problems = cfg.validate()
        assert problems == cfg.arm_blockers() + cfg.advisories()
        assert "voltage channels" in problems[0]


class TestBankRatingToggle:
    def test_defaults_to_110_percent(self):
        limits = SafetyLimits()
        assert limits.bank_rated_power_only is False
        assert limits.to_command_dict()['bank_rated_only'] is False

    def test_survives_round_trip_and_pack_derivation(self, tmp_path):
        cfg = RigConfig.defaults()
        cfg.limits.bank_rated_power_only = True
        loaded = RigConfig.load(cfg.save(str(tmp_path / "rig_config.json")))
        assert loaded.limits.bank_rated_power_only is True

    def test_config_written_before_it_existed_gets_the_default(self):
        assert RigConfig.from_dict({'limits': {}}).limits.bank_rated_power_only is False


class TestSettingsInForce:
    def test_fingerprint_survives_the_trip_to_the_controller(self):
        # The GUI and the logic process must agree when nothing has changed.
        cfg = RigConfig.defaults()
        assert RigConfig.from_dict(cfg.to_dict()).settings_fingerprint() == \
            cfg.settings_fingerprint()

    def test_fingerprint_follows_pack_vehicle_and_wiring_not_limits(self):
        base = RigConfig.defaults().settings_fingerprint()
        for change in (lambda c: setattr(c.pack, 'series_count', 14),
                       lambda c: setattr(c.vehicle, 'mass_car_kg', 300.0),
                       lambda c: c.daq.voltage_channels.pop()):
            cfg = RigConfig.defaults()
            change(cfg)
            assert cfg.settings_fingerprint() != base
        cfg = RigConfig.defaults()
        cfg.limits.max_temp = 60.0          # compared value by value instead
        assert cfg.settings_fingerprint() == base

    def test_moved_warning_line_is_not_a_discarded_hand_edit(self):
        # Display-only, so derivation moving it back is not worth a warning.
        pack = PackConfig()
        limits = SafetyLimits().apply_pack_derivation(pack)
        limits.warn_volts += 3.0
        assert limits.derivation_conflicts(pack) == []
