MBDurbin/VRB/gui_layout.py

import sys
import csv
import math
import time
import os
from dataclasses import fields, replace
from queue import Empty, Full
from multiprocessing import Queue, Event

from rig_config import (
    RigConfig, VehicleParams, PackConfig, DaqConfig, SafetyLimits,
    VEHICLE_FIELD_LABELS, PACK_FIELD_LABELS, DAQ_FIELD_LABELS, field_label,
)
from control_logic import (DEFAULT_LAP_CSV, PROFILES_DIR, PROJECT_DIR, VRB_MAX_POWER_W,
                           BANK_OVERLOAD_FACTOR, transition_command)
import theme
from PyQt6 import QtWidgets, QtCore, QtGui
import pyqtgraph as pg


class MetricCard(QtWidgets.QFrame):
    """A captioned numeric readout.

    The value renders monospaced so the card does not reflow as digits change --
    a proportional font makes live telemetry visibly twitch.
    """

    def __init__(self, caption, initial="--", colour=None):
        super().__init__()
        self.setProperty("variant", "card")
        # Equal, non-shrinking widths. Captions must stay static for this to
        # hold: a caption that grows with its value makes the card reflow mid-run.
        self.setMinimumWidth(150)
        self.setSizePolicy(QtWidgets.QSizePolicy.Policy.Expanding,
                           QtWidgets.QSizePolicy.Policy.Fixed)

        layout = QtWidgets.QVBoxLayout(self)
        layout.setContentsMargins(theme.GAP_MD, theme.GAP_SM, theme.GAP_MD, theme.GAP_SM)
        layout.setSpacing(2)

        self.caption = QtWidgets.QLabel(caption.upper())
        self.caption.setProperty("variant", "caption")

        self.value = QtWidgets.QLabel(initial)
        self.value.setStyleSheet(
            f"font-family: {theme.FONT_MONO}; font-size: 21px; font-weight: 700; "
            f"color: {colour or theme.TEXT}; background: transparent; border: none;"
        )

        layout.addWidget(self.caption)
        layout.addWidget(self.value)

    def set_value(self, text, colour=None):
        self.value.setText(text)
        if colour:
            self.value.setStyleSheet(
                f"font-family: {theme.FONT_MONO}; font-size: 21px; font-weight: 700; "
                f"color: {colour}; background: transparent; border: none;"
            )


# ================= COMMAND DISPATCH =================

def send_command_nonblocking(cmd_queue, cmd):
    """Push a command to the logic process without ever blocking the caller.

    gui_cmd_queue is bounded, and a plain .put() blocks when it is full -- which
    would freeze the whole UI, E-STOP button included, exactly when the operator
    needs it most. If the queue is backed up we discard the oldest command to make
    room, since the commands that realistically pile up (SET_LIMITS) are
    latest-wins anyway. A queued STOP is never discarded.

    Not the E-STOP's path: see request_estop(). Making room is not guaranteed
    with a multiprocessing.Queue, whose get_nowait() can raise Empty for a moment
    after its own puts while the feeder thread flushes them, so this CAN drop a
    command, STOP included.

    Returns True if the command was enqueued, False if it had to be dropped.
    """
    try:
        cmd_queue.put_nowait(cmd)
        return True
    except Full:
        pass

    try:
        stale = cmd_queue.get_nowait()
    except Empty:
        stale = None

    if stale == "STOP" and cmd != "STOP":
        # A pending E-STOP outranks whatever we were trying to send. Put it back
        # and drop the new command instead.
        try:
            cmd_queue.put_nowait(stale)
        except Full:
            pass
        return False

    try:
        cmd_queue.put_nowait(cmd)
        return True
    except Full:
        return False


def request_estop(estop_event, cmd_queue):
    """Raise the E-STOP. Never blocks and is never dropped. Returns True if raised.

    A shared Event rather than a "STOP" on the command queue. The queue is
    bounded, and send_command_nonblocking() can fail to make room in a full
    multiprocessing.Queue, which dropped the STOP while heartbeats carried on,
    so the Arduino's watchdog never shed the load either. An Event has no
    capacity to run out of: it is set here, stays set until the logic process
    takes it, and the logic checks it ahead of every queued command.

    Falls back to the queue only when no event was wired up.
    """
    if estop_event is not None:
        estop_event.set()
        return True
    return send_command_nonblocking(cmd_queue, "STOP")


# ================= CONFIGURATION PROBLEMS =================

def config_problem_text(config):
    """A config's problems for display, ARM blockers first. Empty if none.

    The two groups are labelled apart because they behave differently: the rig
    refuses to arm on the first, and runs with the second.
    """
    sections = []
    blockers = config.arm_blockers()
    if blockers:
        sections.append("WILL NOT ARM -- part of the module or bank is unwatched\n"
                        + "\n".join(f"  - {p}" for p in blockers))
    advisories = config.advisories()
    if advisories:
        sections.append("WARNING\n" + "\n".join(f"  - {p}" for p in advisories))
    return "\n\n".join(sections)


# How each limit is named on screen, for the settings-mismatch warning.
LIMIT_LABELS = {
    'max_amps': "Max current", 'amp_buffer': "E-stop buffer", 'max_temp': "Max temp",
    'min_volts': "V crit", 'min_cell_volts': "Cell min", 'cell_sense_floor': "Cell sense floor",
    'temp_stale_timeout': "Temp stale timeout", 'daq_stale_timeout': "DAQ stale timeout",
    'derate_en': "Thermal derate", 'derate_start': "Derate start",
    'resistor_max_temp': "Resistor trips", 'bank_rated_only': "Bank at rated power only",
}

# How long the controller may take to acknowledge a settings change before the
# window says it is not in force. A command normally lands within ~0.2 s.
SETTINGS_ACK_GRACE_S = 1.0


def _same_setting(a, b):
    if isinstance(a, bool) or isinstance(b, bool):
        return a == b
    if isinstance(a, list) and isinstance(b, list):
        return len(a) == len(b) and all(_same_setting(x, y) for x, y in zip(a, b))
    try:
        return math.isclose(a, b, rel_tol=1e-9, abs_tol=1e-6)
    except TypeError:
        return a == b


def settings_mismatch(config, data):
    """Where the controller's settings in force differ from what the window shows.

    One line per difference, empty when they agree or when the packet does not
    say. The controller rejects a new config while RUNNING, and the bounded
    command queue can drop a SET_LIMITS or SET_CONFIG, so the window's own copy
    is not proof of what is protecting the rig; the controller reports its own
    in every packet.
    """
    lines = []
    active = data.get('active_limits')
    if active:
        for key, shown in config.limits.to_command_dict().items():
            if key not in active or not _same_setting(shown, active[key]):
                lines.append(f"{LIMIT_LABELS.get(key, key)}: shown {shown}, "
                             f"in force {active.get(key, 'unset')}")
    in_force = data.get('active_settings')
    if in_force and in_force != config.settings_fingerprint():
        lines.append("Vehicle, pack or wiring: the controller is still using the previous "
                     "configuration")
    return lines


def arm_refusal_summary(refusals):
    """One line for the main window: the first reason ARM is refused, and a count."""
    if not refusals:
        return ""
    more = f"  (+{len(refusals) - 1} more)" if len(refusals) > 1 else ""
    return f"WILL NOT ARM: {refusals[0]}{more}"


# ================= CONFIGURATION DIALOG =================

class ConfigDialog(QtWidgets.QDialog):
    """Editor for the vehicle model and battery pack.

    Fields are generated from the dataclasses in rig_config, so adding a
    parameter there makes it appear here with no GUI changes needed. Pack limits
    are shown derived live from the per-cell datasheet values, which is the whole
    point: a future team enters their cell's numbers and the pack current,
    voltage and capacity limits follow, instead of being hand-computed.
    """

    def __init__(self, config: RigConfig, parent=None):
        super().__init__(parent)
        self.setWindowTitle("Rig Configuration")
        self.resize(780, 720)

        self.config = config
        self.vehicle_widgets = {}
        self.pack_widgets = {}
        self.daq_widgets = {}

        layout = QtWidgets.QVBoxLayout(self)
        layout.setContentsMargins(theme.GAP_LG, theme.GAP_LG, theme.GAP_LG, theme.GAP_LG)
        layout.setSpacing(theme.GAP_MD)

        heading = QtWidgets.QLabel("RIG CONFIGURATION")
        heading.setProperty("variant", "section")
        layout.addWidget(heading)

        intro = QtWidgets.QLabel(
            "Retarget this rig for a different car or a different cell. Pack limits "
            "are derived from the per-cell datasheet values below, so enter what your "
            "cell is rated for and the pack numbers follow automatically."
        )
        intro.setWordWrap(True)
        intro.setStyleSheet(f"color: {theme.TEXT_DIM}; font-size: {theme.SIZE_SMALL}px;")
        layout.addWidget(intro)

        tabs = QtWidgets.QTabWidget()
        tabs.addTab(self._build_vehicle_tab(), "Vehicle")
        tabs.addTab(self._build_pack_tab(), "Battery Pack")
        tabs.addTab(self._build_daq_tab(), "DAQ / Sensors")
        # The tab area absorbs spare height: the derived and warning panels have
        # large text sizeHints and would otherwise squeeze the form down to a few
        # visible rows.
        layout.addWidget(tabs, 1)

        self.lbl_derived = QtWidgets.QLabel()
        self.lbl_derived.setWordWrap(True)
        self.lbl_derived.setStyleSheet(
            f"background-color: {theme.SURFACE}; border: 1px solid {theme.BORDER_SUBTLE}; "
            f"border-radius: {theme.RADIUS}px; padding: {theme.GAP_MD}px; "
            f"font-family: {theme.FONT_MONO}; font-size: 11px; color: {theme.TEXT_DIM};"
        )
        layout.addWidget(self.lbl_derived)

        self.lbl_warnings = QtWidgets.QLabel()
        self.lbl_warnings.setWordWrap(True)
        self.lbl_warnings.setStyleSheet(
            f"background-color: rgba(248, 81, 73, 0.10); border: 1px solid {theme.DANGER_DIM}; "
            f"border-radius: {theme.RADIUS}px; color: {theme.DANGER}; "
            f"padding: {theme.GAP_MD}px; font-size: {theme.SIZE_SMALL}px;"
        )
        self.lbl_warnings.setVisible(False)
        layout.addWidget(self.lbl_warnings)

        buttons = QtWidgets.QDialogButtonBox(
            QtWidgets.QDialogButtonBox.StandardButton.Save
            | QtWidgets.QDialogButtonBox.StandardButton.Cancel
            | QtWidgets.QDialogButtonBox.StandardButton.RestoreDefaults
        )
        buttons.button(
            QtWidgets.QDialogButtonBox.StandardButton.Save
        ).setProperty("variant", "success")

        buttons.accepted.connect(self.accept)
        buttons.rejected.connect(self.reject)
        buttons.button(
            QtWidgets.QDialogButtonBox.StandardButton.RestoreDefaults
        ).clicked.connect(self.restore_defaults)
        layout.addWidget(buttons)

        self.refresh_derived()

    # --- tab construction -------------------------------------------------

    def _make_editor(self, value):
        """Build an input widget appropriate to the value's type."""
        if isinstance(value, list):
            # Channel lists edit as comma-separated text; order is meaningful
            # (channel i reads the cumulative tap for series group i).
            w = QtWidgets.QLineEdit(", ".join(str(v) for v in value))
            w.setProperty('is_list', True)
            w.editingFinished.connect(self.refresh_derived)
            return w

        if isinstance(value, bool):
            w = QtWidgets.QCheckBox()
            w.setChecked(value)
            w.stateChanged.connect(self.refresh_derived)
        elif isinstance(value, int):
            w = QtWidgets.QSpinBox()
            w.setRange(1, 999)
            w.setValue(value)
            w.setKeyboardTracking(False)
            w.valueChanged.connect(self.refresh_derived)
        elif isinstance(value, float):
            w = QtWidgets.QDoubleSpinBox()
            w.setDecimals(4)
            # Wide enough for any plausible parameter; negative allowed so Cl can
            # express downforce with the usual sign convention.
            w.setRange(-10000.0, 100000.0)
            w.setValue(value)
            w.setKeyboardTracking(False)
            w.valueChanged.connect(self.refresh_derived)
        else:
            w = QtWidgets.QLineEdit(str(value))
            w.editingFinished.connect(self.refresh_derived)

        return w

    def _build_form(self, instance, labels, widget_store):
        container = QtWidgets.QWidget()
        form = QtWidgets.QFormLayout(container)
        form.setContentsMargins(theme.GAP_LG, theme.GAP_LG, theme.GAP_LG, theme.GAP_LG)
        form.setSpacing(theme.GAP_MD)
        form.setLabelAlignment(QtCore.Qt.AlignmentFlag.AlignRight |
                               QtCore.Qt.AlignmentFlag.AlignVCenter)

        for f in fields(instance):
            value = getattr(instance, f.name)
            label_text, unit = field_label(f.name, labels)

            label = QtWidgets.QLabel(
                f"{label_text}"
                + (f" <span style='color:{theme.TEXT_MUTED}; font-size:10px;'>{unit}</span>"
                   if unit else "")
            )
            label.setStyleSheet(f"color: {theme.TEXT_DIM}; font-size: {theme.SIZE_SMALL}px;")

            editor = self._make_editor(value)
            widget_store[f.name] = editor
            form.addRow(label, editor)

        scroll = QtWidgets.QScrollArea()
        scroll.setWidgetResizable(True)
        scroll.setWidget(container)
        return scroll

    def _build_vehicle_tab(self):
        return self._build_form(self.config.vehicle, VEHICLE_FIELD_LABELS, self.vehicle_widgets)

    def _build_pack_tab(self):
        return self._build_form(self.config.pack, PACK_FIELD_LABELS, self.pack_widgets)

    def _build_daq_tab(self):
        return self._build_form(self.config.daq, DAQ_FIELD_LABELS, self.daq_widgets)

    # --- reading values back ---------------------------------------------

    def _read_widget(self, widget):
        if isinstance(widget, QtWidgets.QCheckBox):
            return widget.isChecked()
        if isinstance(widget, (QtWidgets.QSpinBox, QtWidgets.QDoubleSpinBox)):
            return widget.value()
        if widget.property('is_list'):
            return [part.strip() for part in widget.text().split(',') if part.strip()]
        return widget.text()

    def collect(self) -> RigConfig:
        """Build a RigConfig from the current widget values."""
        vehicle = VehicleParams(**{
            name: self._read_widget(w) for name, w in self.vehicle_widgets.items()
        })
        pack = PackConfig(**{
            name: self._read_widget(w) for name, w in self.pack_widgets.items()
        })
        daq = DaqConfig(**{
            name: self._read_widget(w) for name, w in self.daq_widgets.items()
        })

        # A copy. This runs on every keystroke to refresh the preview, and
        # deriving into the window's own limits object changed the live limits
        # whether or not the dialog was saved -- Cancel undid nothing, and the
        # next sidebar edit sent the previewed limits to the controller.
        limits = replace(self.config.limits)
        limits.apply_pack_derivation(pack)
        return RigConfig(vehicle=vehicle, pack=pack, limits=limits, daq=daq)

    # --- live feedback ----------------------------------------------------

    def refresh_derived(self):
        try:
            candidate = self.collect()
        except Exception as exc:
            self.lbl_derived.setText(f"Invalid configuration: {exc}")
            return

        pack, vehicle = candidate.pack, candidate.vehicle
        sag = pack.sag_volts(pack.max_current_a)

        self.lbl_derived.setText(
            f"DERIVED PACK      {pack.series_count}S{pack.parallel_count}P "
            f"= {pack.cell_count} cells\n"
            f"  Capacity        {pack.capacity_ah:.2f} Ah "
            f"({'minimum' if pack.use_minimum_capacity else 'typical'} cell capacity)\n"
            f"  Voltage         {pack.min_voltage:.1f} V cutoff  ->  "
            f"{pack.nominal_voltage:.1f} V nominal  ->  {pack.max_voltage:.1f} V full\n"
            f"  Max current     {pack.max_current_a:.0f} A "
            f"({pack.cell_max_continuous_a:.0f} A/cell x {pack.parallel_count}P)\n"
            f"  Internal R      {pack.resistance_ohm * 1000:.1f} mOhm  "
            f"-> {sag:.1f} V sag at {pack.max_current_a:.0f} A\n"
            f"  Energy          {pack.energy_wh:.0f} Wh\n"
            f"\n"
            f"DERIVED VEHICLE\n"
            f"  Total mass      {vehicle.total_mass_kg:.1f} kg "
            f"({vehicle.total_mass_kg * vehicle.rotational_mass_factor:.1f} kg effective "
            f"under acceleration)\n"
            f"\n"
            f"WIRING            {candidate.daq.channel_count} voltage channels "
            f"for {pack.series_count}S  |  "
            f"{candidate.daq.temp_bus_count}x{candidate.daq.sensors_per_bus} = "
            f"{candidate.daq.sensor_count} thermistors for {pack.cell_count} cells\n"
            f"\n"
            f"RESULTING TRIPS   {candidate.limits.max_amps:.0f} A "
            f"(+{candidate.limits.amp_buffer:.0f} buffer)  |  "
            f"{candidate.limits.max_temp:.0f} C  |  "
            f"{candidate.limits.min_volts:.1f} V\n"
            f"BANK LIMIT        {VRB_MAX_POWER_W / 1000:.1f} kW total and each bank's own rating, "
            f"fixed in control_logic.py and applied whatever the current limit above "
            f"({'100%' if candidate.limits.bank_rated_power_only else f'{BANK_OVERLOAD_FACTOR * 100:.0f}%'}"
            f"; see the sidebar)\n"
            f"RESISTOR TRIPS    "
            + "  |  ".join(f"B{i + 1} {t:.0f} C"
                           for i, t in enumerate(candidate.limits.resistor_max_temp_c))
            + "   (edit in rig_config.json)"
        )

        text = config_problem_text(candidate)
        self.lbl_warnings.setText(text)
        self.lbl_warnings.setVisible(bool(text))

    def restore_defaults(self):
        confirm = QtWidgets.QMessageBox.question(
            self, "Restore defaults?",
            "Reset the vehicle and pack to the shipped Reliance RS50 12S4P defaults?\n\n"
            "This discards your car's parameters.",
            QtWidgets.QMessageBox.StandardButton.Yes | QtWidgets.QMessageBox.StandardButton.No,
            QtWidgets.QMessageBox.StandardButton.No,
        )
        if confirm != QtWidgets.QMessageBox.StandardButton.Yes:
            return

        defaults = RigConfig.defaults()
        for name, w in self.vehicle_widgets.items():
            self._write_widget(w, getattr(defaults.vehicle, name))
        for name, w in self.pack_widgets.items():
            self._write_widget(w, getattr(defaults.pack, name))
        for name, w in self.daq_widgets.items():
            self._write_widget(w, getattr(defaults.daq, name))
        self.refresh_derived()

    def _write_widget(self, widget, value):
        if isinstance(widget, QtWidgets.QCheckBox):
            widget.setChecked(bool(value))
        elif isinstance(widget, (QtWidgets.QSpinBox, QtWidgets.QDoubleSpinBox)):
            widget.setValue(value)
        elif widget.property('is_list'):
            widget.setText(", ".join(str(v) for v in value))
        else:
            widget.setText(str(value))


# ================= HEATMAP WINDOW =================
class HeatmapWindow(QtWidgets.QWidget):
    def __init__(self, series_count=12, parallel_count=4):
        super().__init__()
        # Grid follows the configured pack topology rather than a hardcoded
        # 12S4P, so a future team's pack draws correctly.
        self.series_count = series_count
        self.parallel_count = parallel_count

        self.setWindowTitle(f"{series_count}S{parallel_count}P Thermal Map")
        self.resize(min(1600, 62 * series_count + 80), 82 * parallel_count + 80)

        main_layout = QtWidgets.QVBoxLayout(self)
        main_layout.setContentsMargins(theme.GAP_LG, theme.GAP_MD, theme.GAP_LG, theme.GAP_LG)
        main_layout.setAlignment(QtCore.Qt.AlignmentFlag.AlignCenter)

        self.CELL_SIZE = 52
        self.RADIUS = self.CELL_SIZE // 2

        caption = QtWidgets.QLabel(
            f"CELL TEMPERATURES · {series_count}S × {parallel_count}P")
        caption.setProperty("variant", "section")
        main_layout.addWidget(caption)

        label_layout = QtWidgets.QHBoxLayout()
        label_layout.setAlignment(QtCore.Qt.AlignmentFlag.AlignLeft)
        label_layout.setContentsMargins(0, 0, 0, theme.GAP_XS)
        label_layout.setSpacing(3)

        for i in range(series_count):
            lbl = QtWidgets.QLabel(f"S{i + 1}")
            lbl.setFixedSize(self.CELL_SIZE, 18)
            lbl.setAlignment(QtCore.Qt.AlignmentFlag.AlignCenter)
            lbl.setStyleSheet(
                f"color: {theme.TEXT_MUTED}; font-weight: 700; font-size: 10px; "
                f"letter-spacing: 0.5px;")
            label_layout.addWidget(lbl)

        main_layout.addLayout(label_layout)

        self.cell_labels = [[None for _ in range(series_count)] for _ in range(parallel_count)]

        for row in range(parallel_count):
            row_layout = QtWidgets.QHBoxLayout()
            row_layout.setAlignment(QtCore.Qt.AlignmentFlag.AlignLeft)
            row_layout.setContentsMargins(0, 0, 0, 0)
            row_layout.setSpacing(3)

            for col in range(self.series_count):
                lbl = QtWidgets.QLabel("--")
                lbl.setFixedSize(self.CELL_SIZE, self.CELL_SIZE)
                lbl.setAlignment(QtCore.Qt.AlignmentFlag.AlignCenter)
                lbl.setStyleSheet(self._cell_style(theme.SURFACE_HIGH, theme.TEXT_MUTED))

                row_layout.addWidget(lbl)
                self.cell_labels[row][col] = lbl

            main_layout.addLayout(row_layout)

        swatches = "".join(
            f"<span style='color:{hexcode}'>■</span>" for _, hexcode in theme.HEAT_STOPS)
        legend = QtWidgets.QLabel(f"cool &nbsp;{swatches}&nbsp; at limit")
        legend.setStyleSheet(f"color: {theme.TEXT_MUTED}; font-size: 11px;")
        main_layout.addSpacing(theme.GAP_SM)
        main_layout.addWidget(legend)

    def _cell_style(self, bg, fg):
        return (
            f"background-color: {bg}; color: {fg}; font-family: {theme.FONT_MONO}; "
            f"font-weight: 700; font-size: 12px; border-radius: {theme.RADIUS_SM}px; "
            f"border: 1px solid {theme.BORDER_SUBTLE};"
        )

    def update_temps(self, temp_array, current_max_safe_temp):
        flat_temps = []
        for bus in temp_array:
            flat_temps.extend(bus)

        for col in range(self.series_count):
            for row in range(self.parallel_count):
                sensor_idx = (col * self.parallel_count) + row

                if sensor_idx < len(flat_temps):
                    t = flat_temps[sensor_idx]
                    colour, ratio = theme.heat_colour(t, current_max_safe_temp)
                    # Keep text legible across the whole ramp: dark on the bright
                    # mid-range, white at both cool and hot extremes.
                    text_colour = "#ffffff" if (ratio < 0.35 or ratio > 0.75) else "#14171c"

                    self.cell_labels[row][col].setText(f"{t:.0f}")
                    self.cell_labels[row][col].setStyleSheet(
                        self._cell_style(colour, text_colour))


# ================= RESISTOR BANK MAP =================
# The bank as built, viewed along the elements (docs/hardware_topology.md,
# "Cooling", and the tube-bank geometry in analysis/CFM Calculator.py). The fan sits below
# and blows UP, so air meets the flat bars first and the top row last.
#
#   top row     bank 1: four 1 ohm TE2000 elements side by side. The only bank in
#               circuit at the 0.25 ohm floor, so it carries the peak duty.
#   middle row  banks 2 and 3: three TE2000 elements offset into the top row's
#               gaps, so the array is a staggered tube bank.
#   bottom row  banks 4-8 on four sideways aluminium flat bars.
#
# NOT RECORDED anywhere in the repo: which middle-row position is bank 3, and
# where banks 4-8 sit on the flat bars. Both are drawn in bank order. Correct
# these two tuples if the bank is surveyed.
MIDDLE_ROW_BANKS = (2, 3, 2)
FLAT_BAR_BANKS = (4, 4, 5, 6, 7, 8, 8)

# What each bank is built from, for the table beside the map.
BANK_PARTS = {
    1: "4 × 1 Ω TE2000", 2: "2 × 1 Ω TE2000", 3: "1 × 1 Ω TE2000",
    4: "2 × 4 Ω Uxcell", 5: "4 Ω Uxcell", 6: "8 Ω Ohmite HS300",
    7: "16 Ω Ohmite HS200", 8: "2 × 16 Ω Ohmite HS200",
}
BANK_COUNT = 8


def bank_tile(temp, age, limit, stale_timeout_s):
    """(fill colour, status) for one bank's tile on the resistor map.

    The colour ramps from cool to red at THAT bank's trip, so a glance compares
    each bank against its own limit rather than against the hottest one.
    `temp` is None for a bank with no thermocouple or no reading yet.
    """
    if temp is None:
        return theme.SURFACE_HIGH, ("NO SENSOR" if limit is None else "NO DATA")
    colour, _ = theme.heat_colour(temp, limit)
    if temp >= limit:
        return colour, "OVER"
    if stale_timeout_s > 0 and age > stale_timeout_s:
        return colour, "STALE"
    return colour, "OK"


class ResistorBankCanvas(QtWidgets.QWidget):
    """Paints the bank's cross-section, each element coloured by its bank."""

    PITCH = 104         # element spacing, px: ~2.07 diameters, the real 124 mm on 60 mm
    RADIUS = 26

    def __init__(self):
        super().__init__()
        self.setMinimumSize(5 * self.PITCH, 430)
        self.tiles = {}             # bank -> (fill, label text, status)

    def set_tiles(self, tiles):
        self.tiles = tiles
        self.update()

    @staticmethod
    def _outline(status):
        """Over trip: heavy white, since the fill is already red. Stale: dashed red."""
        if status == "OVER":
            pen = QtGui.QPen(QtGui.QColor(theme.TEXT), 3)
        elif status == "STALE":
            pen = QtGui.QPen(QtGui.QColor(theme.DANGER), 3)
            pen.setStyle(QtCore.Qt.PenStyle.DashLine)
        else:
            pen = QtGui.QPen(QtGui.QColor(theme.BORDER), 1)
        return pen

    def _tube(self, p, cx, cy, bank):
        fill, text, status = self.tiles.get(bank, (theme.SURFACE_HIGH, "", "NO SENSOR"))
        p.setPen(self._outline(status))
        p.setBrush(QtGui.QColor(fill))
        p.drawEllipse(QtCore.QPointF(cx, cy), self.RADIUS, self.RADIUS)
        self._text(p, QtCore.QRectF(cx - self.RADIUS, cy - 10, 2 * self.RADIUS, 20), text,
                   bold=True, colour="#ffffff")
        self._text(p, QtCore.QRectF(cx - self.RADIUS, cy + self.RADIUS + 2, 2 * self.RADIUS, 14),
                   f"B{bank}", colour=theme.TEXT_MUTED, size=9)

    def _text(self, p, rect, text, bold=False, colour=None, size=10,
              align=QtCore.Qt.AlignmentFlag.AlignCenter):
        font = p.font()
        font.setPointSize(size)
        font.setBold(bold)
        p.setFont(font)
        p.setPen(QtGui.QColor(colour or theme.TEXT_DIM))
        p.drawText(rect, align, text)

    def paintEvent(self, event):
        p = QtGui.QPainter(self)
        p.setRenderHint(QtGui.QPainter.RenderHint.Antialiasing)
        w = self.width()
        x0 = w / 2 - 1.5 * self.PITCH           # left tube of the 4-wide rows
        y_top, y_mid, y_bars = 70, 160, 250

        self._text(p, QtCore.QRectF(0, 18, w, 18), "EXHAUST ↑", colour=theme.TEXT_MUTED, size=9)

        # Top row: bank 1.
        for i in range(4):
            self._tube(p, x0 + i * self.PITCH, y_top, 1)

        # Middle row: offset into the gaps above.
        for i, bank in enumerate(MIDDLE_ROW_BANKS):
            self._tube(p, x0 + (i + 0.5) * self.PITCH, y_mid, bank)

        # Bottom row: four flat bars, on edge, under the top row's tubes.
        p.setPen(QtGui.QPen(QtGui.QColor(theme.BORDER)))
        p.setBrush(QtGui.QColor(theme.SURFACE_HOVER))
        for i in range(4):
            p.drawRoundedRect(QtCore.QRectF(x0 + i * self.PITCH - 4, y_bars - 32, 8, 64), 2, 2)

        # Banks 4-8 as blocks along the bar row. Positions are not recorded.
        span = 3 * self.PITCH + 2 * self.RADIUS
        step = span / len(FLAT_BAR_BANKS)
        for i, bank in enumerate(FLAT_BAR_BANKS):
            fill, text, status = self.tiles.get(bank, (theme.SURFACE_HIGH, "", "NO SENSOR"))
            rect = QtCore.QRectF(x0 - self.RADIUS + i * step + 3, y_bars - 14, step - 6, 28)
            p.setPen(self._outline(status))
            p.setBrush(QtGui.QColor(fill))
            p.drawRoundedRect(rect, 3, 3)
            self._text(p, rect, text or f"B{bank}", bold=bool(text),
                       colour="#ffffff" if text else theme.TEXT_MUTED, size=9)
        self._text(p, QtCore.QRectF(0, y_bars + 38, w, 14),
                   "banks 4–8 on the flat bars · positions not recorded",
                   colour=theme.TEXT_MUTED, size=8)

        # Fan and airflow.
        y_fan = 370
        for i in range(4):
            x = x0 + (i - 0.5) * self.PITCH + self.PITCH / 2
            p.setPen(QtGui.QPen(QtGui.QColor(theme.ACCENT), 2))
            p.drawLine(QtCore.QPointF(x, y_fan - 12), QtCore.QPointF(x, y_bars + 58))
            p.drawLine(QtCore.QPointF(x, y_bars + 58), QtCore.QPointF(x - 5, y_bars + 66))
            p.drawLine(QtCore.QPointF(x, y_bars + 58), QtCore.QPointF(x + 5, y_bars + 66))
        p.setPen(QtGui.QPen(QtGui.QColor(theme.BORDER)))
        p.setBrush(QtGui.QColor(theme.SURFACE))
        fan = QtCore.QRectF(x0 - self.RADIUS, y_fan - 10, 3 * self.PITCH + 2 * self.RADIUS, 26)
        p.drawRoundedRect(fan, 6, 6)
        self._text(p, fan, "FAN · blows up", colour=theme.TEXT_DIM, size=9)
        p.end()


class ResistorMapWindow(QtWidgets.QWidget):
    """Live thermal map of the resistor bank, laid out as the bank is built."""

    def __init__(self):
        super().__init__()
        self.setWindowTitle("Resistor Bank Thermal Map")

        layout = QtWidgets.QHBoxLayout(self)
        layout.setContentsMargins(theme.GAP_LG, theme.GAP_MD, theme.GAP_LG, theme.GAP_LG)
        layout.setSpacing(theme.GAP_LG)

        left = QtWidgets.QVBoxLayout()
        caption = QtWidgets.QLabel("RESISTOR BANK · VIEWED ALONG THE ELEMENTS")
        caption.setProperty("variant", "section")
        left.addWidget(caption)
        self.canvas = ResistorBankCanvas()
        left.addWidget(self.canvas, 1)
        swatches = "".join(
            f"<span style='color:{hexcode}'>■</span>" for _, hexcode in theme.HEAT_STOPS)
        legend = QtWidgets.QLabel(f"cool &nbsp;{swatches}&nbsp; at that bank's trip · "
                                  f"white outline: over trip · dashed red: stale reading")
        legend.setStyleSheet(f"color: {theme.TEXT_MUTED}; font-size: 11px;")
        left.addWidget(legend)
        layout.addLayout(left, 1)

        # Per-bank table.
        table = QtWidgets.QGridLayout()
        table.setHorizontalSpacing(theme.GAP_MD)
        table.setVerticalSpacing(theme.GAP_XS)
        for col, head in enumerate(("BANK", "BUILT FROM", "TEMP", "TRIP", "STATUS")):
            lbl = QtWidgets.QLabel(head)
            lbl.setStyleSheet(f"color: {theme.TEXT_MUTED}; font-size: 10px; font-weight: 700;")
            table.addWidget(lbl, 0, col)
        self.rows = {}
        mono = f"font-family: {theme.FONT_MONO}; font-size: {theme.SIZE_SMALL}px;"
        for bank in range(1, BANK_COUNT + 1):
            cells = [QtWidgets.QLabel(t) for t in
                     (f"{bank}", BANK_PARTS[bank], "--", "--", "")]
            for col, lbl in enumerate(cells):
                lbl.setStyleSheet(mono + f"color: {theme.TEXT_DIM};")
                table.addWidget(lbl, bank, col)
            self.rows[bank] = cells
        table.setRowStretch(BANK_COUNT + 1, 1)
        layout.addLayout(table)

        self.resize(980, 500)

    def update_banks(self, temps, ages, limits, stale_timeout_s):
        """temps/ages: per thermocoupled bank, bank 1 first. limits: per bank, C."""
        tiles = {}
        for bank in range(1, BANK_COUNT + 1):
            i = bank - 1
            sensed = i < len(temps)
            temp = temps[i] if sensed else None
            age = ages[i] if i < len(ages) else float('inf')
            # Matches control_logic.resistor_limit(): no trip of its own means
            # the strictest one set.
            limit = (limits[i] if i < len(limits) else min(limits, default=0.0)) if sensed else None
            fill, status = bank_tile(temp, age, limit, stale_timeout_s)
            text = f"{temp:.0f}" if temp is not None else ""
            tiles[bank] = (fill, text, status)

            _, _, lbl_temp, lbl_trip, lbl_status = self.rows[bank]
            lbl_temp.setText(f"{temp:.1f} °C" if temp is not None else "--")
            lbl_trip.setText(f"{limit:.0f} °C" if limit is not None else "--")
            lbl_status.setText(status)
            colour = {"OK": theme.SUCCESS, "OVER": theme.DANGER, "STALE": theme.DANGER,
                      "NO DATA": theme.WARNING}.get(status, theme.TEXT_MUTED)
            lbl_status.setStyleSheet(
                f"font-family: {theme.FONT_MONO}; font-size: {theme.SIZE_SMALL}px; "
                f"font-weight: 700; color: {colour};")
        self.canvas.set_tiles(tiles)
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
