MBDurbin/VRB/tests/test_logic_loop.py

"""
The real logic loop, driven through its queues, for behaviour the pure-function
tests cannot reach: what ARM does, and what reaches the resistor controller,
when the NI-DAQ is missing or is lost mid-run.

No hardware. The resistor controller is a fake that records what is written to
it, the DAQ is a thread feeding packets, and the config is the built-in
defaults rather than whatever rig_config.json holds. Each test takes about a
second.
"""
import os
import queue
import sys
import threading
import time

import pytest
import serial

sys.path.insert(0, os.path.dirname(os.path.dirname(os.path.abspath(__file__))))

import control_logic as cl
from rig_config import RigConfig


def daq_packet(ni_daq, amps=50.0):
    """A healthy rig with the DAQ up, or what hardware_manager sends without it."""
    packet = {
        'amps': amps, 'voltage': 46.0, 'cell_voltages': [3.85] * 12, 'power_kw': 2.3,
        'temperatures': [[30.0] * 8 for _ in range(6)], 'max_temp': 30.0,
        'temp_age_s': 0.05, 'temp_sensor_ages_s': [[0.05] * 8 for _ in range(6)],
        'resistor_temps': [40.0] * 4, 'resistor_temp_ages_s': [0.05] * 4,
        'hardware_status': {'temp_arduino': True, 'ni_daq': ni_daq, 'res_arduino': False},
    }
    if not ni_daq:
        packet.update(amps=0.0, voltage=0.0, cell_voltages=[], power_kw=0.0)
    return packet


def is_resistance_command(data):
    text = data.decode(errors="replace").strip()
    return len(text) == 8 and set(text) <= {"0", "1"}


class FakeResistor:
    def __init__(self):
        self.is_open = True
        self.fail = False       # set to make every write raise, like a pulled cable
        self.writes = []
        self._lock = threading.Lock()

    def write(self, data):
        if self.fail:
            raise serial.SerialException("WriteFile failed")
        with self._lock:
            self.writes.append(bytes(data))

    def written(self):
        with self._lock:
            return list(self.writes)

    def close(self):
        self.is_open = False


class Rig:
    """run_logic_process on a thread, with a DAQ feeder and a telemetry tap."""

    def __init__(self, monkeypatch):
        self.resistor = FakeResistor()
        # Discovery finds the controller while it is open. Once the logic closes
        # a failed handle it stays gone, as an unplugged board would.
        monkeypatch.setattr(cl, "auto_detect_resistor",
                            lambda discovery_lock=None:
                            self.resistor if self.resistor.is_open else None)
        # What the logic process loads at startup. Replace before start().
        self.config = RigConfig.defaults()
        monkeypatch.setattr(RigConfig, "load", staticmethod(lambda *a, **k: self.config))

        self.ni_daq = True
        self.amps = 50.0
        self.daq_q = queue.Queue(maxsize=5)
        self.tel_q = queue.Queue(maxsize=50)
        self.cmd_q = queue.Queue(maxsize=10)
        self.stop = threading.Event()
        self.estop = threading.Event()   # the GUI's E-STOP signal
        self.seen = []          # every fsm_state forwarded, in order
        self.last = None        # the latest packet forwarded
        self.crash = None       # what run_logic_process raised, if anything
        self.threads = []

    def _logic(self):
        try:
            cl.run_logic_process(self.daq_q, self.tel_q, self.cmd_q, self.stop,
                                 None, self.estop)
        except Exception as exc:
            self.crash = exc

    def _feed(self):
        while not self.stop.is_set():
            if self.daq_q.full():
                try:
                    self.daq_q.get_nowait()
                except queue.Empty:
                    pass
            self.daq_q.put(daq_packet(self.ni_daq, self.amps))
            time.sleep(0.05)

    def _tap(self):
        while not self.stop.is_set():
            try:
                self.last = self.tel_q.get(timeout=0.1)
                self.seen.append(self.last['fsm_state'])
            except queue.Empty:
                pass
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
