MBDurbin/VRB/(commit log)

2026-07-24 Add v2 modular telemetry system with safety fixes and validation suite
    Splits the resistor bank master into separate processes: hardware_manager
    (NI-DAQ + temp sensors), control_logic (FSM + lap physics), gui_layout
    (PyQt6 telemetry), and sil_simulator (desk-test plant model).
    Safety fixes:
    - main_v2.py never started the DAQ process in physical hardware mode, so
    daq_queue stayed empty and the control loop never ran without the SIL
    dongle. The resistor bank and safety monitors were effectively dead.
    - auto_detect_resistor() probed at 115200 baud while the resistor Arduino
    runs at 9600, so the ?WHOAMI handshake could never succeed.
    - Resistor reconnect scans ran on every DAQ tick with n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
    [FSAE - ETS - Speed and Time 1 Lap.csv]
2026-07-25 Align safety limits with P45B datasheet, add undervoltage protection
    Validated every battery-derived constant against the Molicel INR-21700-P45B
    v1.2 datasheet for the 12S4P pack. Pack IR (45 mohm = 15 mohm/cell / 4P * 12S),
    full-charge voltage (50.4 V), cutoff voltage (30.0 V) and nameplate capacity
    (18.0 Ah) all checked out exactly. Three things did not.
    Undervoltage protection did not exist at all. V Warn and V Crit were wired only
    to the dashed lines on the voltage plot and were never included in limits_dict,
    so they never reached the logic process -- check_safety_trip only ever saw
    temperature and current, and nothing prevented a discharge past the 2.5 V/cell
    cutoff. This bites under l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
    [control_logic.py, gui_layout.py, sil_simulator.py, test_control_logic.py]
2026-07-27 Parameterise the vehicle model, add rotational mass and drivetrain loss
    Every road-load constant was hardcoded inside compute_required_power(): air
    density, Cd, reference area, Cl, rolling coefficient, gravity and the two
    masses. They are now fields on a VehicleParams dataclass, so the simulation can
    be retuned without touching the physics -- either by mutating DEFAULT_VEHICLE or
    by passing a variant per call.
    Adds two mechanical effects the model was missing:
    - Rotational inertia. F = ma only accounts for pushing the car forward, not for
    spinning up wheels, brake rotors, axles and drivetrain, which is significant
    on a ~330 kg formula car. Modelled as rotational_mass_factor (default 1.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
    [control_logic.py, test_control_logic.py]
2026-07-27 Make the rig retargetable from the GUI for future teams
    Inheriting this rig meant editing Python to use it with a different car or
    different cells. Vehicle parameters, the pack spec and every safety limit now
    live in rig_config.py, are editable from a Configure dialog in the GUI, and
    persist to rig_config.json.
    Pack limits are DERIVED from per-cell datasheet values times the series and
    parallel counts rather than entered directly. Enter 45 A continuous and 4P and
    the 180 A pack rating follows; nobody should be hand-computing a pack limit. The
    dialog shows derived capacity, voltage range, internal resistance, sag at max
    current and the resulting trip points live as you type, and warns in red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
    [control_logic.py, gui_layout.py, rig_config.py, test_rig_config.py]
2026-07-27 Drive the DAQ layer from config and rebuild the interface on a design system
    Two related pieces of work. The config now reaches through the Python hardware
    layer, and the GUI it feeds is styled from one place instead of ~90 scattered
    inline stylesheets.
    DAQ layer follows the configured pack
    -------------------------------------
    hardware_manager.py hardcoded a 12-channel voltage map and a 6x8 sensor grid, so
    the config work stopped at the software boundary. Channel mapping, divider and
    transducer scaling, analog input range, OneWire bus/sensor counts and the loop
    period now live in a DaqConfig section of rig_config.json, editable from a new
    DAQ / Sensors tab.
    Channel names and sensor addres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
2026-07-28 Fix 9x under-loading, add per-cell and sensor-integrity trips
    Three safety gaps, all of which let the rig report healthy while something was
    wrong.
    Bench under-loaded the module by 9x
    -----------------------------------
    The bench loads ONE 12S4P module (~50 V) but the lap physics computes power for
    the whole car, drawn from nine modules in series (~450 V). Reproducing a
    module's real duty means reproducing its CURRENT, since series modules all carry
    the same one:
    I_car = P_car / (N * V_module)
    R = V_module / I_car = N * V_module^2 / P_car
    The module count entered the power term as (voltage * 9) ** 2 -- N squared
    rather than N, which is the resistance a bank spanning the entire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
    [control_logic.py, gui_layout.py, hardware_manager.py, rig_config.py, sil_simulator.py, test_control_logic.py, test_rig_config.py]
2026-08-07 Disable rotational inertia pending measurement, annotate assumptions
    Sets rotational_mass_factor to 1.00 so the road-load model no longer adds
    virtual mass under acceleration. The 1.05 default was a textbook figure for an
    open-wheel car, not a measured property of this one; running at 1.00 keeps the
    model honest until the real rotational inertia of the wheels, rotors, axles and
    drivetrain is measured. Note this makes the bench slightly UNDER-load during
    acceleration relative to the real car.
    Annotates the parameters that are still assumptions rather than measurements:
    drivetrain efficiency, and the DAQ channel and sensor layout, which needs
    verifying against the physical wiring and will cha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
    [rig_config.py, test_control_logic.py]
2026-08-10 Report hand-edited limits that pack derivation discards
    Editing a limit in rig_config.json while leaving derive_from_pack true had the
    edit silently reverted on load: max_amps set to 120 A came back as 175 A. The
    reversion runs in the unsafe direction -- a deliberate derate is undone and the
    rig runs at a higher limit than the engineer set, with nothing said.
    Derivation staying authoritative is deliberate and is kept. Deriving only for
    freshly-defaulted limits would reintroduce a worse bug: changing the pack from
    4P to 8P would leave the old pack's 180 A ceiling in place on cells rated for
    360 A. The problem is the silence, not the overwrite.
    SafetyLimits.derivation_conflicts() now probes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
    [gui_layout.py, rig_config.py, test_rig_config.py]
2026-08-10 Stop the logic loop stalling, failing open, and glitching lap boundaries
    Eight defects from two review passes. Several shared a shape: a check that
    looked present but could not fire, or fired on a fabricated number.
    Logic loop no longer skips its own body
    ---------------------------------------
    `continue` on an empty DAQ queue jumped past GUI commands, every safety check,
    the resistor heartbeat and telemetry forwarding. A hung or crashed DAQ therefore
    paralysed the logic process -- the operator's E-STOP sat unread in the queue and
    the GUI kept displaying RUNNING. The Arduino's 2 s watchdog still shed the load,
    so the hardware was safe, but nothing in software noticed or reported it.
    The lo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
    [control_logic.py, rig_config.py, test_control_logic.py, test_rig_config.py]
2026-08-11 Document rig_config line by line for inheriting teams
    This is the file a future team edits to retarget the rig, and it is the one they
    are most likely to read without knowing the codebase. Comments now cover what
    each value is, what it is derived from, where it is consumed, and what breaks if
    it is wrong.
    The commentary favours the non-obvious over restating the code. Highlights:
    - Units and safe ranges on every field, and which are hard datasheet figures
    versus assumptions still awaiting measurement.
    - Physics that is easy to get backwards: parallel count multiplies current and
    capacity but not voltage; series modules share one current, so current limits
    do not scale with module cou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
    [rig_config.py]
2026-08-11 Bring the Arduino firmware under version control
    The three sketches the rig depends on lived outside the repo -- two in OneDrive
    and one in Downloads, where Storage Sense deletes files on a schedule. The
    resistor bank sketch in particular carries an independent safety layer: its 2 s
    serial watchdog opens the main contactor and sheds the load when the host goes
    quiet, which is what actually protects the rig while the Python side is stalled
    in a COM-port scan. Ten commits of software safety work were tracked; the
    hardware backstop they lean on was not backed up anywhere.
    Restructured for the Arduino IDE, which requires the folder name to match the
    sketch name. The resistor sketch was previous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
    [ds18b20_address_scanner.ino, resistor_bank_controller.ino, temperature_sensor_array.ino]
2026-08-11 Add bench utilities used to bring the hardware up
    Standalone scripts predating the v2 architecture, each talking to one device
    directly rather than through the process pipeline. Committed as written -- they
    are a record of how the hardware was characterised, not code the rig depends on.
    discover DAQ.py Enumerates NI-DAQ devices and prints every analog
    input channel. This is where the cDAQ1Mod5-8 names
    in rig_config.py came from.
    Current Sensor.py Streams one channel and scales it, documenting the
    LEM HAC 400-S as +/-4 V for +/-400 A -- the origin
    of DaqConfig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
2026-08-11 Add the tkinter GUI prototypes that preceded the PyQt6 interface
    Two single-file tkinter experiments from before gui_layout.py existed. Kept for
    the design decisions visible in them rather than for reuse -- the 12x4 thermal
    grid and the blue-to-red cell colouring both started here and carried into the
    PyQt6 version, where the ramp was later replaced because blue-to-red passes
    through a muddy purple midpoint.
    GUI example.py Fully simulated: fake physics, fake temperatures, no
    hardware. The layout sketch.
    GUI_TEMP_CHECK.py Reads the real temperature Arduino on COM6 and renders
    48 live sensors. The first working thermal map.
    WARNING: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
    [GUI example.py, GUI_TEMP_CHECK.py]
2026-08-11 Add the forced-convection cooling analysis for the resistor bank
    Sizes the airflow needed to keep the resistor bank's surface temperature in
    range, treating the resistors as a staggered tube bank in cross-flow -- the
    standard Zukauskas correlation geometry. Answers "how much fan do we need" and
    "how many resistors can we cool", which is why the sensitivity sweeps exist.
    CFM Calculator.py The model. Geometry constants at the top (D, ST, SL,
    SD, NL, a 2 ft x 2 ft duct), then interpolated gas
    properties, V_max, Reynolds, Nusselt and surface
    temperature, swept across airflow and resistor count.
    Gas_Prope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
    [Gas_Properties_ATMP.csv]
2026-08-11 Update the single-file v1 controller and add its unit tests
    Master_Code_v1.py grows from a serial-only script into a self-contained
    application: adds NI-DAQ acquisition, a temperature reader, a physics worker and
    a tkinter interface, each on its own thread. This is the design the v2 process
    architecture replaced -- threads sharing globals behind locks, rather than
    separate processes communicating over queues. Committed as written.
    test master.py is the unittest suite aimed at it, covering the road-load
    resistance formula, ohms-to-8-bit-binary conversion including both clamps, and
    that the heartbeat thread actually writes b"alive\n".
    THE TWO NO LONGER MATCH. This rewrite removes both functi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
    [Master_Code_v1.py, test master.py]
2026-08-11 Add the P45B datasheet the safety limits were derived from
    Every constant in PackConfig traces to this document, but until now the code
    only cited it ("Product Data Sheet v1.2") and left anyone verifying the numbers
    to go find the right revision themselves. Revision matters here: these values
    were checked against v1.2 specifically.
    382 KB, well inside what git handles comfortably; no LFS needed. Renamed from
    the browser's "...-80109 (1).pdf" so the part number and revision are legible.
    Copied rather than moved -- the original stays in Downloads, where Storage Sense
    would eventually have removed it.
    Redistributed as a manufacturer datasheet; copyright remains E-One Moli Energy
    Corp. The rep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
2026-08-15 Add the TE Series resistor datasheet and note two ratings to check
    TE Connectivity TE Series high-power wirewound, doc 9-1773453-2 Rev. E 05/2021 --
    the braking resistors that make up the bank. Its listed applications are load
    test simulation and dynamic braking, which is precisely this rig. 287 KB.
    Copied from Downloads; copyright remains TE Connectivity.
    The README records the ratings and, more usefully, works out how they meet the
    bank as actually configured. The ladder is a series chain across a ~50 V module,
    so minimum resistance means maximum current, and that current runs through the
    one element that is on its own. The 0.25 ohm step therefore carries the peak duty
    of the entire syste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
2026-08-15 Document the physical VRB topology
    Extracted from the project work log, which is not itself in this repo -- it is a
    personal record with hours and a live GitHub token in it. Only the engineering
    content is here.
    Records what the code could not previously tell anyone: what each ladder step is
    physically built from, how the bank is arranged for cooling, and the DS18B20 ROM
    address map. Bank composition existed nowhere in this repo before, which is why
    the resistor datasheet commit had to leave two ratings as unverifiable.
    Those ratings can now be checked, and the answer is that the design sits about
    1% inside its limits at the over-current trip, not 3.6x over as the worst case
    in that commit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
2026-08-15 Give each device a single owner for port discovery
    hardware_manager and control_logic both swept every COM port for RESISTOR_CTRL.
    control_logic is the real owner -- it holds that port open for the life of the
    run -- so hardware_manager could never claim it. That had three consequences,
    the first of which is the reason this matters:
    - res_port stayed None permanently, so needs_res never went false and the
    watchdog kept sweeping every 3 s for the life of the process instead of
    going quiet once the temperature sensor was connected. Each pass blocked 2 s
    per baud rate per port.
    - Opening and closing a port toggles DTR, which hard-resets the Arduino on it.
    control_logic has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
    [hardware_manager.py, resistor_bank_controller.ino]
2026-08-20 Take port discovery off the safety loop and stop padding logs with 0.0
    Four findings from an external audit pass. One was incorrect and one was my own
    stale documentation.
    Discovery no longer blocks the safety-critical loop
    ---------------------------------------------------
    control_logic called auto_detect_resistor() inline. It blocks ~2 s per COM port,
    and during that stall the main loop serviced nothing: not the GUI command queue,
    so a pressed E-STOP sat unread; not the safety checks; not telemetry forwarding,
    so the display froze with it. The Arduino watchdog covered the hardware, but
    leaning on it to paper over a stall inside the safety process is structural, not
    incidental.
    Discovery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
    [control_logic.py, gui_layout.py, hardware_manager.py, main_v2.py, sil_simulator.py]
2026-09-21 Retarget the pack config from the Molicel P45B to the Reliance INR21700-RS50
    Capacity 4.5 -> 5.0 Ah typical and 4.3 -> 4.95 Ah minimum, continuous discharge
    45 -> 70 A, operating ceiling 60 -> 80 C, DC impedance 15 -> 4 mOhm.
    Two consequences, both because the safety limits derive from the cell numbers:
    * The over-current trip becomes 70 A x 4P - 5 A buffer = 275 A, which the
    resistor bank cannot carry. At its 0.25 ohm floor and 50.4 V the bank draws
    about 200 A, so the trip can no longer fire before the bank's own limit, and
    Bank 1 would sit around 25% over its 2 kW element rating -- the 200 A row in
    docs/hardware_topology.md. Gap 3 in that file raised this when the trip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
    [rig_config.py]
2026-09-21 Add a bench tool for checking which relay switches which resistor bank
    Takes a resistance at a prompt and sends the exact string the rig would send,
    borrowing send_binary_command from control_logic rather than copying it, so it
    always exercises the encoding actually in use. Prints which Arduino pin each
    command should switch and what a meter across the ladder should read, so the
    wiring can be checked against the software's assumption with no battery fitted.
    It exists because the firmware and the Python disagree about bit order.
    resistor_bank_controller.ino labels pin 5 -- driven by the last character of the
    command -- as the 0.25 ohm relay, while send_binary_command reverses the string,
    whi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
    [bench_relay_check.py]
2026-09-21 Add the cooling analysis plots and the packaged audit snapshot
    Output of CFM Calculator.py, plus the bundle handed to the external code audit.
    Generated rather than source, kept so the analysis behind the fan sizing sits
    next to the script that produced it.
2026-09-30 Annotate hardware_manager with inline explanations of the parsing and config steps
    Comment-only. Says what each guard in derive_cell_voltages and
    parse_temperature_line is discarding and why (empty tap list, a bus line whose
    field count does not match the layout, a non-integer bus id, a bus outside the
    configured range), and notes what the startup config print is reporting. No
    behaviour change.
2026-09-30 Model the worst-case cooling of the resistor bank: airflow solver and transient thermal analysis
    Nothing in the software watches the bank's temperature and the fan has no
    interlock (docs/hardware_topology.md, gaps 1 and 2), so the cooling margin
    rests entirely on the airflow the fan provides. These scripts quantify that
    margin for the worst case: the ladder at its 0.25 ohm floor, where only Bank 1
    -- the four-element top row -- carries current.
    CFM Calculator.py is rewritten around that case. Aerodynamics use the whole
    3-row, 11-tube array; the heat balance uses only the four heated elements. The
    heat is fixed (a resistor is a source, not a thermostat), the surface
    temperature is the unknow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
    [Gas_Properties_ATMP.csv]
2026-10-05 Fault when any single temperature sensor stops reporting while armed
    The temperature Arduino prints ERR for a DS18B20 it cannot read, and the DAQ
    skips that field, so the sensor's last value stays in the array. The other
    sensors keep the stream as a whole fresh, so neither TEMP LINK LOST nor TEMP
    DATA STALE fires: one cell's reading could sit frozen at a safe-looking value
    while the cell kept heating.
    hardware_manager now records when each sensor last gave a valid reading and
    publishes temp_sensor_ages_s in every packet, laid out [bus][sensor] like the
    temperature array. A sensor that has never given a number reads inf, so it
    cannot pass as fresh. The parser also rejects "nan" and "inf", wh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
    [control_logic.py, hardware_manager.py, rig_config.py, sil_simulator.py, test_control_logic.py, test_hardware_manager.py]
2026-10-05 Close the main relay only on a valid command; feed the watchdog only with control traffic
    Three changes to how the resistor controller and the host talk, made together
    because each one closes a gap the others leave open.
    1. Validate before energising. The sketch closed the main relay as soon as a
    line got past the handshakes, before checking it. A malformed line closed
    it and left it closed until the 2 s watchdog fired. A short binary word
    such as "0101", or a line cut off by the read timeout, updated only some
    ladder relays and left the rest at their old setting. Even KILL closed the
    relay an instant before opening it again. The sketch now identifies every
    message first.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
    [bench_relay_check.py, control_logic.py, resistor_bank_controller.ino, test_control_logic.py]
2026-10-05 Add relay_timing_check.py: replay the host's serial traffic against the relay rules
    A desk check for main-relay chatter that needs no Arduino, DAQ or battery. It
    runs control_logic's real logic loop against a fake resistor controller that
    timestamps every line written to it. It then replays those lines through a
    model of the sketch's rules: close on a valid 8-digit command; open on KILL or
    after 2 s without "alive" or a valid command; nothing else moves a relay or
    resets the watchdog.
    Four scenarios run in parallel, about 20 s in all:
    normal 1 s rows, 2 laps including a lap wrap
    slow rows rows 2 s apart
    corrupt one resistance command mangled on the wire
    host hang host s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
    [relay_timing_check.py]
2026-10-05 Hold the resistor bank to its 8 kW rating whatever the current limit allows
    The current limit is derived from the cells, and nothing in the software knew
    about the bank. With the Reliance RS50 cells (70 A each) it works out to 275 A,
    about 14 kW at 50 V. The GUI's Max Amp box goes to 2000 A. So a config edit, a
    sidebar change or a cell swap could command the bank past its rating.
    VRB_MAX_POWER_W = 8000 is now a constant in control_logic.py, deliberately not
    a rig_config field: every field there can be edited from the GUI. It is
    enforced twice:
    * Command floor. resistance_floor() is the highest of the current-limit
    clamp, the thermal derate and bank_power_floor() = V^2 / (0.95 * 8 kW)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
    [control_logic.py, gui_layout.py, test_control_logic.py]
2026-10-05 Trip on resistor bank temperature, and add a bank map laid out as built
    Every trip protected the cells; nothing watched the resistors. Banks 1-4 now
    have one thermocouple each, read by the NI-DAQ.
    Reading (hardware_manager). Based on Bryce Marshall's bench test,
    tests/test_tc.py in 2db1bb4 on origin/master (Type K, cDAQ1Mod3). His test left
    two settings at nidaqmx's defaults, and both are now explicit:
    * cold junction: the default is a FIXED 25 C (CONSTANT_USER_VALUE); this
    uses the module's built-in sensor (BUILT_IN)
    * expected range: the default 0-100 C is below what the banks reach; this
    uses -40..600 C
    The thermocouples have their own task on their own thread, read every 0.2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
    [control_logic.py, gui_layout.py, hardware_manager.py, relay_timing_check.py, rig_config.py, sil_simulator.py, test_control_logic.py, test_hardware_manager.py]
2026-10-05 Fix the 14 config tests the RS50 retarget left expecting P45B figures
    53f76a4 moved the pack defaults from the Molicel P45B to the Reliance RS50 but
    left tests/test_rig_config.py asserting P45B numbers against PackConfig(),
    so 14 tests failed on this branch while passing on master. The derivation
    code was fine; the tests had tied "the defaults" to one specific cell.
    Three kinds of fix, keeping what each test was for:
    * Datasheet checks (capacity, minimum capacity, sag, the 3.2 V/cell sag
    hazard, the 175 A / 60 C limits) now run on an explicit P45B pack. Its
    datasheet is in datasheets/; there is no RS50 datasheet in the repo to
    check RS50 figures against. The sag-hazard test n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
    [test_rig_config.py]
2026-10-07 Sort the repo into folders and add a README that maps them
    The top level mixed four kinds of file: the rig app, bench tools, the offline
    cooling analysis with nine plots, and superseded prototypes. The app stays at
    the top level, so running it and its imports are unchanged. Everything else
    moves (git mv, so history follows each file):
    profiles/ the lap speed profile
    tools/ bench_relay_check, relay_timing_check, discover DAQ,
    Current Sensor, and Bryce's thermocouple bench test (was
    tests/test_tc.py, now thermocouple_check.py: it is a bench
    script, not a test)
    analysis/ CFM Calculator, resistor_thermal, the gas property table,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
    [FSAE - ETS - Speed and Time 1 Lap.csv, Gas_Properties_ATMP.csv]
2026-10-08 Fail closed without the NI-DAQ instead of simulating a healthy pack
    If the NI-DAQ failed to start, hardware_manager substituted a healthy pack at
    rest (15 A, every cell at nominal + 0.5 V) and the rig ran on it. Started
    without the SIL dongle, that drove the real bank while the over-current,
    undervoltage and cell trips watched made-up numbers.
    * hardware_manager publishes zero current, zero volts and no cells with
    hardware_status['ni_daq'] False. Desk testing on simulated data is what
    the SIL dongle is for.
    * A read failure mid-session no longer ends the DAQ process (which left the
    logic process to notice only once DAQ DATA STALE timed out). It marks the
    DAQ offline and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
    [control_logic.py, hardware_manager.py, test_control_logic.py, test_hardware_manager.py, test_logic_loop.py]
2026-10-08 Refuse ARM on configuration that leaves part of the rig unwatched
    Wiring and config problems were printed as warnings and the rig armed anyway,
    so parts of the module or bank could go unmeasured. They now come in two
    classes:
    * ARM blockers (RigConfig.arm_blockers()): a voltage-tap count that does
    not match the series count, the current channel or a thermocouple on a
    voltage input, duplicate channels, an invalid thermocouple type or
    cold-junction source, a zero, negative or NaN divider or transducer
    scale (negative reads discharge as negative, which never reaches the
    over-current trip), and a staleness timeout at zero.
    * Advisories, shown and left to the operator: li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
    [control_logic.py, gui_layout.py, hardware_manager.py, rig_config.py, test_control_logic.py, test_gui_config_text.py, test_logic_loop.py, test_rig_config.py]
2026-10-08 Hold each resistor bank to its own power rating, with a 140% switch
    The 8 kW limit was a ladder total, but the ladder is series with bypass
    relays: a command of N steps puts in circuit the banks whose bits are set in
    N, and a bank alone carries the whole current. At 50.4 V the 8 kW total let
    0.5 ohm put bank 2 at 5.1 kW against its 4 kW, 1 ohm put bank 3 at 2.5 kW
    against 2 kW, and 2 ohm put bank 4 at 1.3 kW against 1 kW.
    * BANK_RATED_POWER_W, from the bank table in docs/hardware_topology.md.
    Every setting sent is checked against the ladder total and each bank in
    circuit, at the measured module voltage with elements at the low end of
    tolerance. Per-bank power is not monotonic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
    [control_logic.py, gui_layout.py, relay_timing_check.py, rig_config.py, test_control_logic.py, test_logic_loop.py, test_rig_config.py]
2026-10-08 Send E-STOP as a latched event instead of through the command queue
    send_command_nonblocking() makes room in a full queue by taking an old command
    out, and a multiprocessing.Queue can refuse that get_nowait() for a moment
    after its own puts while the feeder thread flushes them. A STOP pressed into
    a full queue could therefore be dropped, and since heartbeats carried on, the
    Arduino's watchdog would never have shed the load either.
    E-STOP now sets a shared estop_event (gui_layout.request_estop()), wired from
    main_v2 to the GUI and the logic process. An Event has no capacity to run out
    of; it stays set until the logic loop takes it, ahead of every queued command.
    A "STOP" on the queue is stil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
2026-10-08 Publish telemetry without blocking on a drained queue
    control_logic and hardware_manager both published with `if q.full():
    q.get()` then `q.put()`. The consumer can drain the queue between full() and
    get(), and get() then waits forever. In the logic process that froze the
    safety loop: no trips, no STOP handling, no heartbeats. In the DAQ it
    silenced every reading.
    queue_util.put_latest() never blocks: put_nowait, and if full drop the oldest
    and try once more; if a multiprocessing.Queue still cannot make room, this
    packet is dropped and the next one tries again. The logic process, the DAQ
    and the SIL plant all publish through it (the SIL's put() could block the Qt
    thread).
    Tests: the helper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
2026-10-08 Treat a failed controller write as a lost link, and always clean up
    Heartbeat and resistance-command write failures were swallowed without
    invalidating the handle, and reconnection depended only on is_open, so the
    GUI could keep showing a connected controller and RUNNING while nothing
    reached the Arduino. The KILL writes for STOP, trips and run completion were
    unguarded, and a failure there crashed the logic process past its cleanup.
    * Every write goes through write_resistor(), which returns False rather
    than raising. A failed heartbeat, command or KILL, or a port that closes
    under the loop, closes the handle, re-arms discovery and, if ARMED or
    RUNNING, latches FAULT (RESISTOR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
    [control_logic.py, test_control_logic.py, test_logic_loop.py]
2026-10-08 Check readings are finite, plausible and complete before trusting them
    NaN loses every comparison, so a packet of NaN current, voltage and cells
    passed every trip, and a packet with one cell, one temperature sensor and one
    thermocouple passed too, because nothing counted them.
    measurement_problems() runs once armed, ahead of any check that reads a
    value:
    * INVALID READING: current, voltage, max cell temperature, any cell or any
    resistor temperature that is not a finite number, or a NaN age; current
    below -20 A (a reversed or saturated transducer hides over-current); a
    module above 110% of full or a cell more than 0.8 V above full (neither
    can trip undervoltage); a cell te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
    [control_logic.py, hardware_manager.py, test_control_logic.py, test_hardware_manager.py, test_logic_loop.py]
2026-10-08 Block ARM on limits that cannot protect: past a rating or not finite
    Trips set past a cell or bank rating were only advisories, so the sidebar
    could arm the rig with a 2000 A over-current trip or a 0 V undervoltage trip,
    and a NaN limit was not flagged at all -- a trip set to NaN never fires.
    limit_problems() joins the ARM blockers: over-current trip above the pack
    rating, max temp above the cell's ceiling, module or per-cell undervoltage
    below the cutoff, a resistor trip above its element's rating, and any limit
    that is not a finite number. It runs on the limits the logic process holds,
    so a sidebar edit is judged the moment it arrives; one that lands while
    armed faults as CONFIG FAULT. A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
2026-10-08 Make the GUI show the settings the controller is actually using
    Configure applied and saved a new config in the window even while RUNNING,
    when the controller ignores one, with no acknowledgement, so a lowered max
    temp could look active when it was not. A SET_LIMITS or SET_CONFIG dropped
    by the bounded queue went unnoticed the same way.
    * The logic process reports its limits in force and a fingerprint of its
    vehicle, pack and wiring (RigConfig.settings_fingerprint()) in every
    packet. A difference lasting over a second shows in red beside the car
    and pack label, naming the setting.
    * Configure is refused while RUNNING.
    * The Configure preview derived into the window's live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
2026-10-08 Reconcile the docs and SIL plant with the Reliance RS50 cells
    The modules use Reliance RS50 cells (21700, 5000 mAh, 70 A), but the docs,
    comments and SIL plant still described the Molicel P45B (45 A, 60 C,
    45 mOhm). The supplier's listing gives 5000/4950 mAh, 3.6 V nominal, 4.2 V
    peak and 70 A "with 80 C temperature cut-off"; it gives no discharge cutoff
    or internal resistance, so the 2.5 V and 4 mOhm in the config are flagged as
    unsourced wherever they appear.
    * rig_config.json said max_amps 180, the P45B figure. With derive_from_pack
    it was replaced by the RS50's 275 A on every load, behind a "hand-edited
    limits were replaced" dialog; it now says 275, so the file states what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
    [control_logic.py, gui_layout.py, rig_config.py, sil_simulator.py, test_shipped_limits.py, test_sil_plant.py]
2026-10-09 Send the resistance word in the bit order the firmware reads
    send_binary_command wrote the word least significant bank first, but
    resistor_bank_controller.ino drives its LAST character onto BANK_1_RELAY, pin 5,
    the 0.25 ohm relay. So a 32 ohm command went out as 00000001: the firmware
    bypassed every other bank and left bank 1 alone in circuit, about 202 A / 10 kW
    at 50.4 V instead of 1.6 A / 79 W. Every single-bank command landed on the
    wrong bank; only symmetric words such as 11111111 came out right, which is why
    an all-ones check could never catch it.
    The wire format is now defined once, in control_logic: COMMAND_BANKS gives the
    bank each character switches (most significant first, so the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
    [bench_relay_check.py, control_logic.py, relay_timing_check.py, resistor_bank_controller.ino, test_control_logic.py, test_firmware_bank_map.py]
2026-10-09 Stop a queued RESET, ARM and RUN from undoing an E-STOP
    The logic loop takes the E-STOP event, latches FAULT and sends KILL, then works
    through the command queue. A RESET, ARM and RUN already waiting there were
    accepted in order, so the rig was RUNNING again in the same pass as the stop,
    and the next resistance command reconnected the load. The same held for any
    trip: a RESET pressed before it cleared it unseen.
    ARM, RUN and RESET now carry the time they were pressed (transition_command(),
    time.monotonic(), system-wide on Windows and Linux), and the loop records when
    it last entered FAULT (latch_fault(), used by every stop and trip, and by an
    E-STOP pressed while already in FAULT). A transi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
    [control_logic.py, gui_layout.py, relay_timing_check.py, test_control_logic.py, test_logic_loop.py]
